rac2030/IoT-conference-badge/images/design-prototype-modular-approach.png

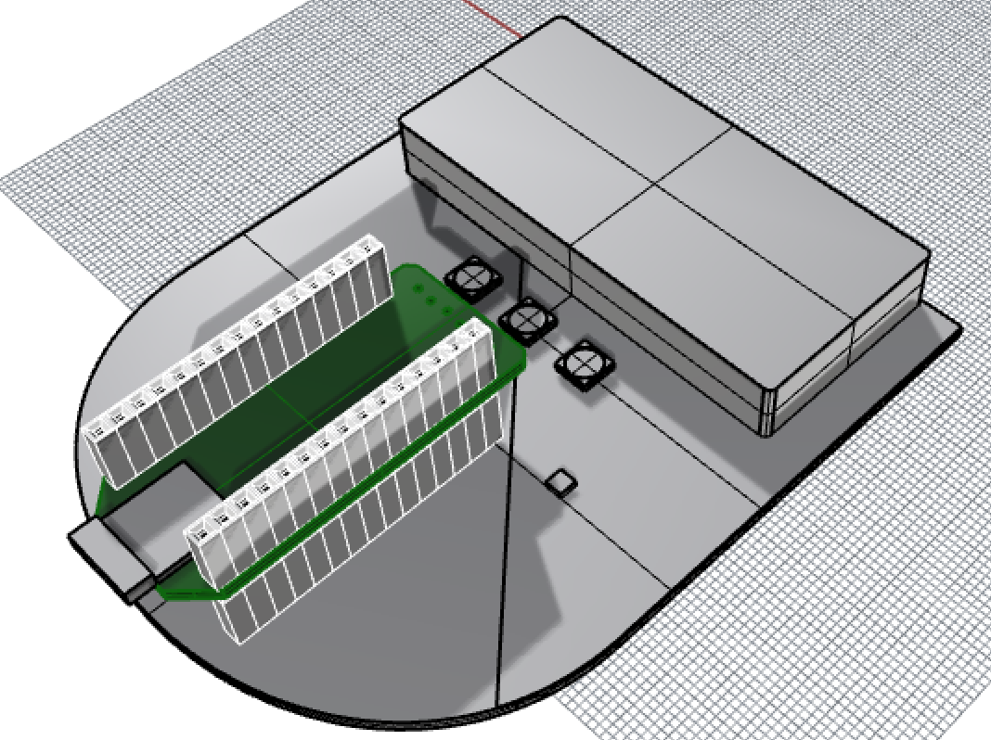
images/design-prototype-modular-approach.png
