rac2030/IoT-conference-badge/README.md

# IoT-conference-badge
Hardware badge to be used in MakeZürich 2018 (https://makezurich.ch) and GDG DevFest Switzerland 2018 (https://devfest.ch)

More info for the uC module used here can be found on http://rac.su/ninab together with the sources (it's on GitHub as well)
