rac2030/IoT-conference-badge/firmware/examples/i2c_scanner/README.md

# i2c scanner

Sample sketch to scan the I2C bus and report found devices. It's the 
same code as seen on the [Arduino Playground](https://playground.arduino.cc/Main/I2cScanner),
with the only difference of adapting the `Serial` speed to the defaults of the NINA module.
