rac2030/IoT-conference-badge/firmware/examples/LED-OFF/README.md

# LED OFF

Turns off both LEDs on the MakeZurich badge 2018 to reset in case a new programm will be flashed that does not set the LED state hence they keep the last state.
