rac2030/IoT-conference-badge/firmware/examples/LED-Siren/README.md

# LED Siren example

Just flashes different patterns that mimik a US police siren with red and blue on the MakeZurich badge 2018
