rac2030/IoT-conference-badge/firmware/examples/sht-autodetect/README.md

# SHT-Autodetect

Very simple sensor test using Sensirion SHT sensors (tested with SHT31) based on the examples of [Sensirion's Arduino SHT lib](https://github.com/Sensirion/arduino-sht).

## Wiring

* `SCL` -> `IO35` (NINA nomenclature)
* `SDA` -> `IO36` (NINA nomenclature)
* `VCC` -> `VCC`
* `GND` -> `GND`

## Libraries

Install the following libraries using Arduino IDE (`Sketch` -> `Include Library` -> `Manage Libraries...`):

* [Sensirion's Arduino SHT](https://github.com/Sensirion/arduino-sht)
