rac2030/IoT-conference-badge/graphics/DuckTapeApproved.bmp

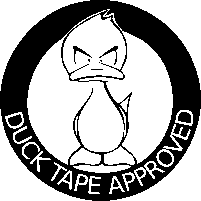
graphics/DuckTapeApproved.bmp
