rac2030/IoT-conference-badge/graphics/qr-racsu-mz18quest.png

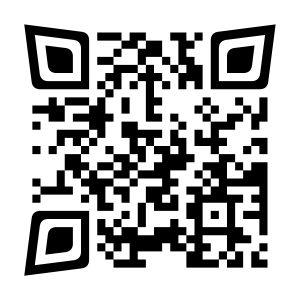
graphics/qr-racsu-mz18quest.png
