rac2030/IoT-conference-badge/3d-models/parts/headers/BG130-05-X-0350-X-X_revE.STEP

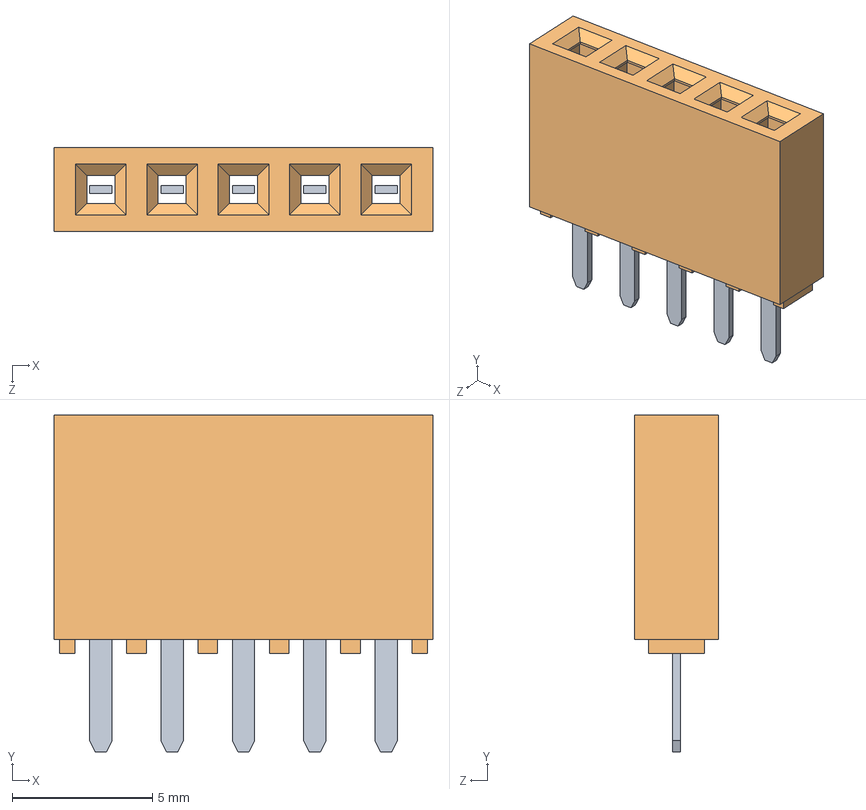
[picture p4: CAD file, 2018-05-28]
3d-models/parts/headers/BG130-05-X-0350-X-X_revE.STEP
13.5 x 12.0 x 3.00 mm
BG130-PIN x 5
BG130-05-INS
