rac2030/IoT-conference-badge/hardware/kicad-libs/SamacSys/LDO/LIB_LTC3101EUF#PBF/LTC3101EUF#PBF/3D/LTC3101EUF#PBF.stp

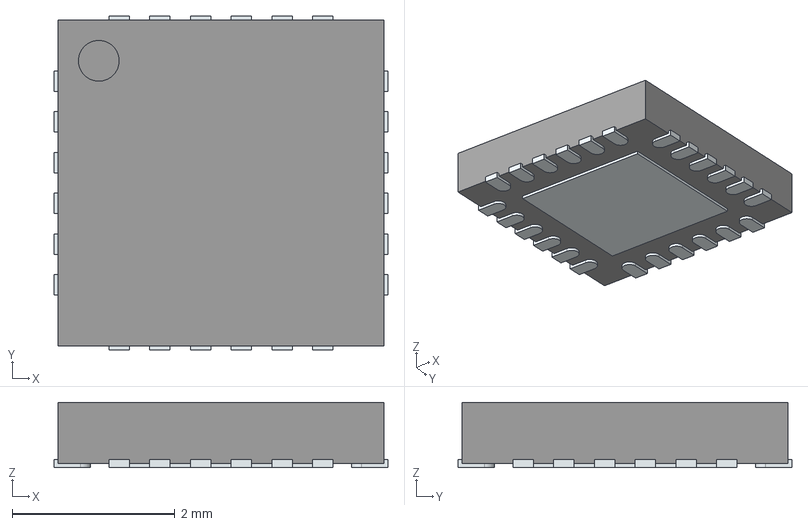
[picture p5: CAD file, 2018-05-28]
hardware/kicad-libs/SamacSys/LDO/LIB_LTC3101EUF#PBF/LTC3101EUF#PBF/3D/LTC3101EUF#PBF.stp
4.10 x 4.10 x 0.8 mm
ThermalPin
PinsArrayLR
PinsArrayTB
