rac2030/IoT-conference-badge/hardware/kicad-libs/SamacSys/LDO/TPS767D318PWP.stp

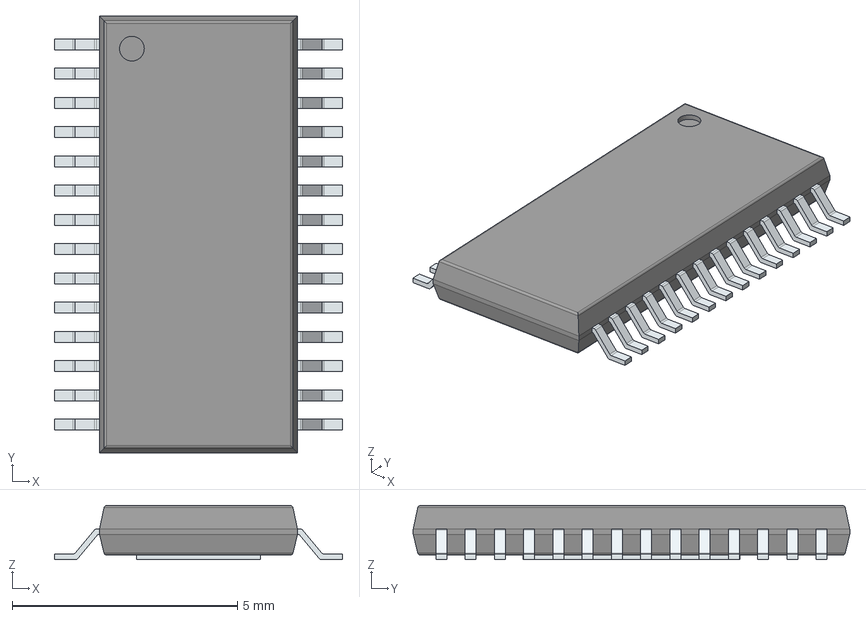
[picture p6: CAD file, 2018-05-28]
hardware/kicad-libs/SamacSys/LDO/TPS767D318PWP.stp
6.40 x 9.70 x 1.20 mm
PinsArrayLR
ThermalPad
