rac2030/IoT-conference-badge/hardware/kicad-libs/SamacSys/LIB_CP2102N-A01-GQFN20/CP2102N-A01-GQFN20/3D/CP2102N-A01-GQFN20.stp

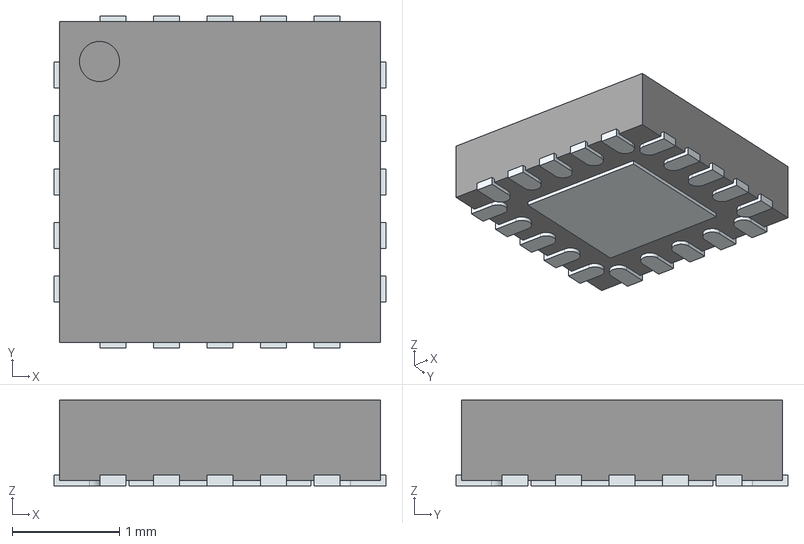
[picture p7: CAD file, 2018-05-28]
hardware/kicad-libs/SamacSys/LIB_CP2102N-A01-GQFN20/CP2102N-A01-GQFN20/3D/CP2102N-A01-GQFN20.stp
3.10 x 3.10 x 0.8 mm
ThermalPin
PinsArrayLR
PinsArrayTB
