rac2030/IoT-conference-badge/hardware/kicad-libs/SamacSys/PCA9306/PCA9306TDCURQ1.stp

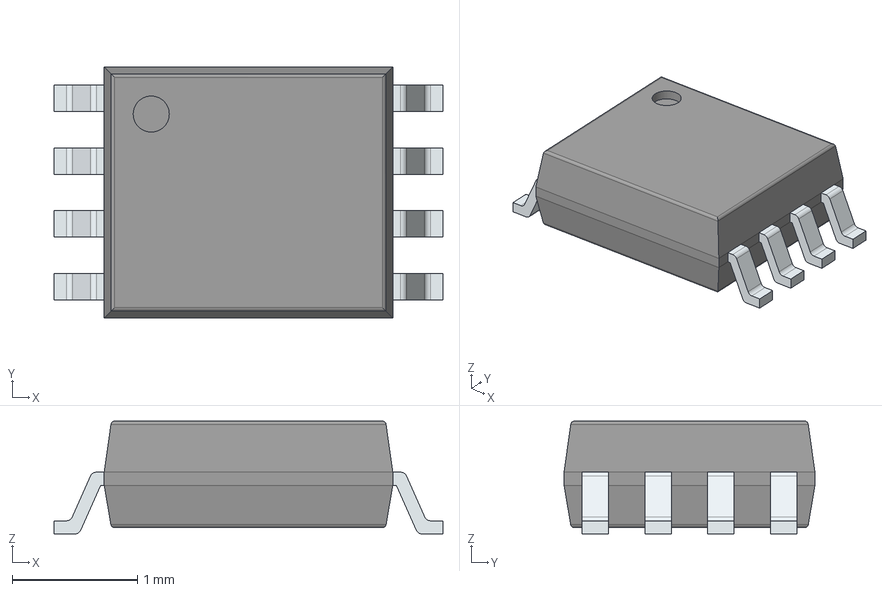
[picture p8: CAD file, 2018-05-28]
hardware/kicad-libs/SamacSys/PCA9306/PCA9306TDCURQ1.stp
3.10 x 2.00 x 0.9 mm
PinsArrayLR
