rac2030/IoT-conference-badge/hardware/kicad-libs/SamacSys/Sensirion/SGPC3-2.5k.stp

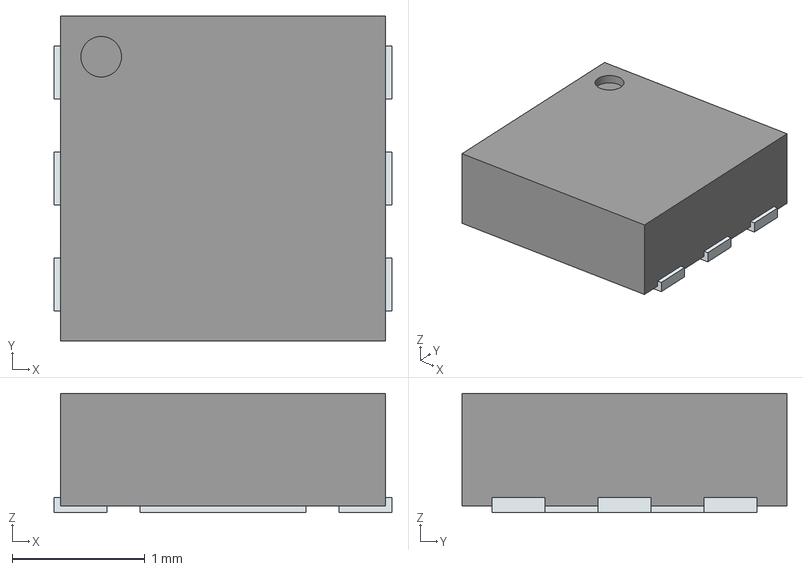
[picture p9: CAD file, 2018-05-28]
hardware/kicad-libs/SamacSys/Sensirion/SGPC3-2.5k.stp
2.55 x 2.45 x 0.9 mm
ThermalPin
PinsArrayLR
