rac2030/IoT-conference-badge/3d-models/parts/headers/BG045-10-X-0600-0300-X-X_revD.STEP

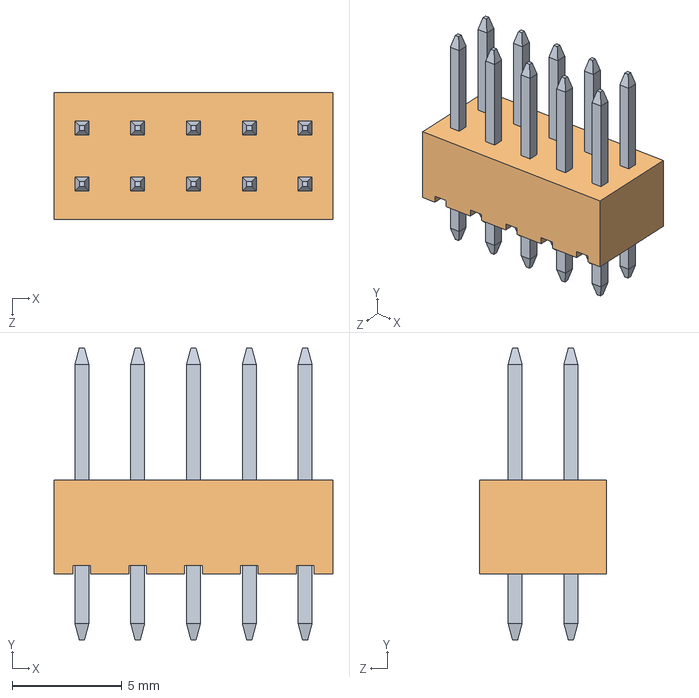
[picture p10: CAD file, 2018-05-28]
3d-models/parts/headers/BG045-10-X-0600-0300-X-X_revD.STEP
12.7 x 13.3 x 5.80 mm
BG045-Contact-0600-0300 x 10
BG045-10con-Insulator
