rac2030/IoT-conference-badge/hardware/kicad-libs/SamacSys/Sensirion/SHTC1.stp

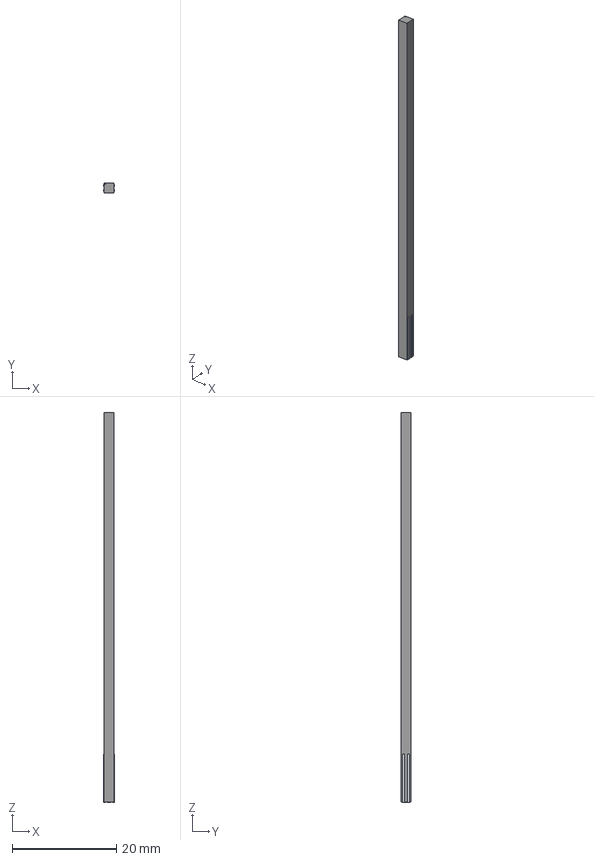
[picture p11: CAD file, 2018-05-28]
hardware/kicad-libs/SamacSys/Sensirion/SHTC1.stp
2.10 x 2.00 x 75.0 mm
ThermalPin
PinsArrayLR
