rac2030/IoT-conference-badge/3d-models/parts/headers/BG180-10-X-0-X-X_revE.STEP

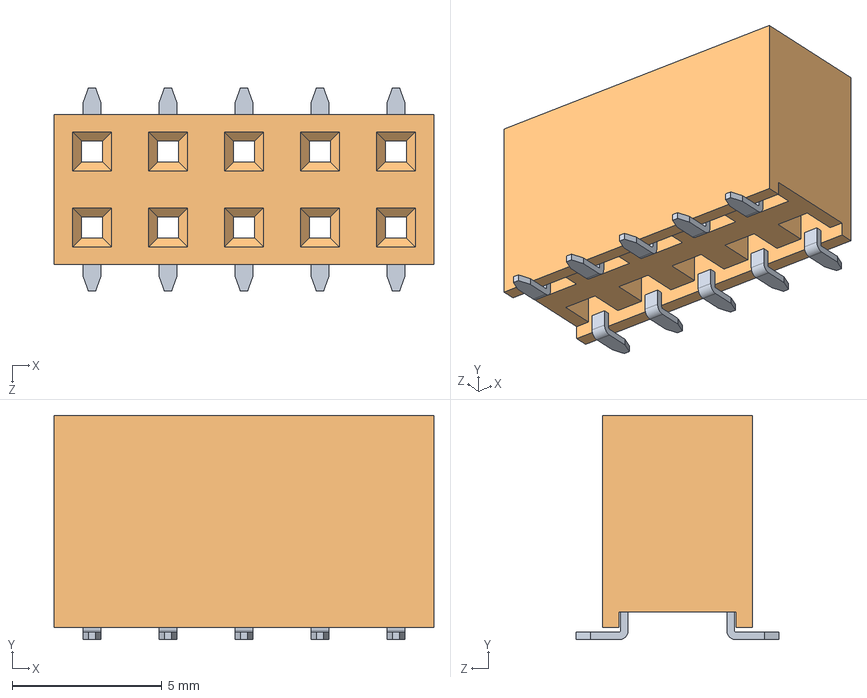
[picture p12: CAD file, 2018-05-28]
3d-models/parts/headers/BG180-10-X-0-X-X_revE.STEP
12.7 x 7.50 x 6.80 mm
BG180-Contact x 10
BG180-5way_insulator
