rac2030/IoT-conference-badge/3d-models/parts/headers/BG120-40-X-1-X-X_revD.STEP

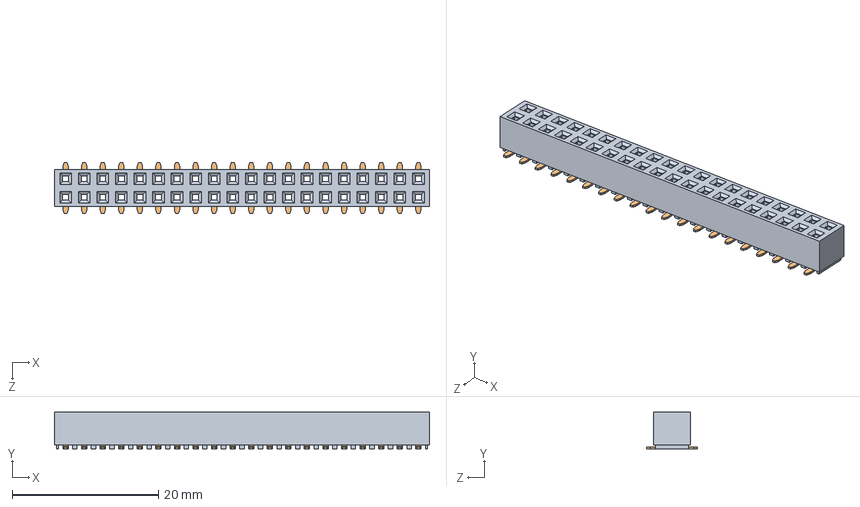
[picture p13: CAD file, 2018-05-28]
3d-models/parts/headers/BG120-40-X-1-X-X_revD.STEP
51.3 x 5.00 x 7.00 mm
BG120-20way-Ins-w-post
BG120-Contact x 40
