rac2030/IoT-conference-badge/hardware/kicad-libs/SamacSys/TPS78918DBVT/3D/TPS78918DBVT.stp

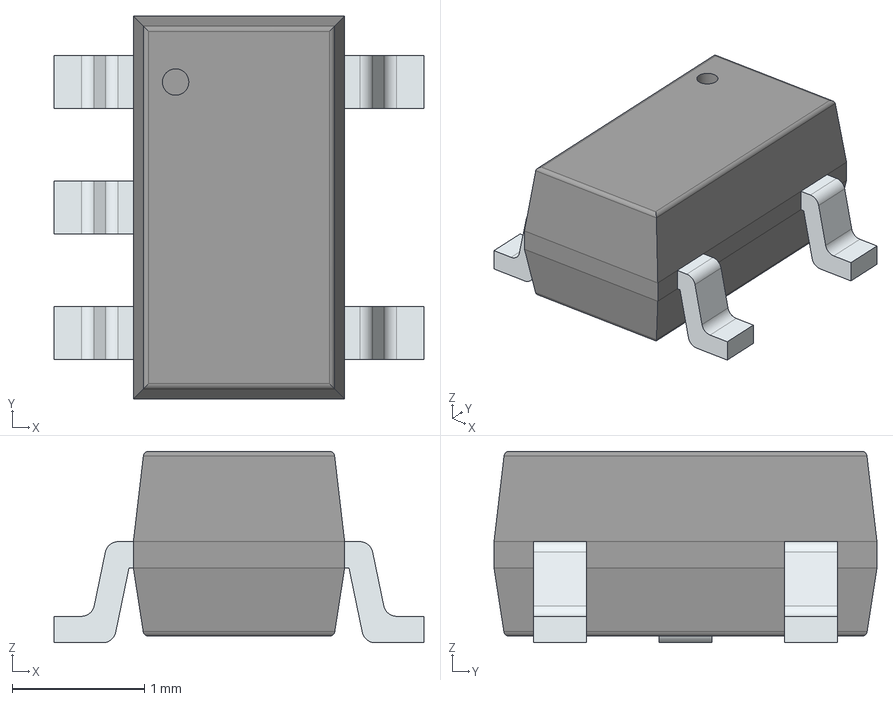
[picture p14: CAD file, 2018-05-28]
hardware/kicad-libs/SamacSys/TPS78918DBVT/3D/TPS78918DBVT.stp
2.80 x 2.90 x 1.45 mm
PinsArrayL
PinsArrayR
