rac2030/IoT-conference-badge/(list of files, cad)

Other CAD files:
hardware/kicad-libs/SamacSys/LDO/LIB_LTC3101EUF#PBF/LTC3101EUF#PBF/3D/LTC3101EUF#PBF.stl
hardware/kicad-libs/SamacSys/LDO/TPS767D318PWP.stl
hardware/kicad-libs/SamacSys/LIB_CP2102N-A01-GQFN20/CP2102N-A01-GQFN20/3D/CP2102N-A01-GQFN20.stl
hardware/kicad-libs/SamacSys/PCA9306/PCA9306TDCURQ1.stl
hardware/kicad-libs/SamacSys/Sensirion/SGPC3-2.5k.stl
hardware/kicad-libs/SamacSys/Sensirion/SHTC1.stl
hardware/kicad-libs/SamacSys/TPS78918DBVT/3D/TPS78918DBVT.stl
