rac2030/IoT-conference-badge/hardware/kicad-libs/SamacSys/TPS78918DBVT/How_To_Use_Models.pdf

ECAD PART WIZARD.

Supports:

Offers engineers full control of the symbol fracturing and symbol pin positions (left, right, top, bottom). ECAD Symbols & footprints can be downloaded directly from within the EPW application or from manufacturer and RS Component website.

DOWNLOAD: http://componentsearchengine.com/EPW.html

LIBRARY LOADER.
Allows Engineers to click our icon from any webpage and it injects the symbols and footprint directly into your chosen library and attached them to your cursor ready for placement.

DOWNLOAD: http://componentsearchengine.com/LibraryLoader.php

SamacSys is a leading developer of software tools for creating and managing electronic component ECAD data.

## 3 ways to use our ECAD Schematic Symbols & PCB footprints

Supports:

DIRECT MODEL DOWNLOAD FOR MANUAL USE.
Our Schematic Symbols and PCB Footprint can be downloaded in a zip file for the user to manually load into their existing ECAD Library.

DOWNLOAD: http://componentsearchengine.com

Automatically load
models into your
library and attach
them to your cursor
by clicking our icon
on any website.

WATCH VIDEO (https://componentsearchengine.com/pcb-libraries.php)

Excel plug in. Search
for parts from within
Excel, customise the
fracturing and export
to your chosen ECAD
Tool.

WATCH VIDEO (http://www.samacsys.com/epw/)

You may download our
symbols & footprints in
the format of your
ECAD system for
manually loading into
your library.

MORE INFO (http://www.samacsys.com/pcb-part-libraries/)

Supports:
