rac2030/IoT-conference-badge/(threads)

Thread 10 (2018-06-05):

Monitor buttons and trigger action accordingly

rac2030, 2018-06-05:
Ideally using interrupts to wake up from sleep and then evaluate and take appropriate action

rac2030, 2018-06-27:
Has been implemented in taskButtons

Closed 2018-06-27.

Thread 22 (2018-06-05):

Voting application

rac2030, 2018-06-05:
Small application that lets admins issue a vote that gets displayed on each badge and participants can use the 4 buttons to select an option.
This needs a frontend as well as some firmware code to handle that interaction.

Thread 3 (2018-06-05):

Display chip serial as QR code on display

rac2030, 2018-06-05:
If no display name set yet, show QR code or barcode with serial number for scanning

rac2030, 2018-06-07:
Sample code:
chipid=ESP.getEfuseMac();//The chip ID is essentially its MAC address(length: 6 bytes).
	Serial.printf("ESP32 Chip ID = %04X",(uint16_t)(chipid>>32));//print High 2 bytes
	Serial.printf("%08X\n",(uint32_t)chipid);//print Low 4bytes.

rac2030, 2018-06-07:
Some QR code libraries:

- https://github.com/budnail/QR_Code_Gen3
- https://github.com/ricmoo/QRCode
- https://github.com/davidhend/QR-Code-Generator

rac2030, 2018-06-25:
The taskScheduler example shows a demo integration together with tasks and signals splitting generation and displaying

rac2030, 2018-06-26:
Has been implemented in taskQRInit.cpp that gets triggered from taskinit.cpp when the badge powers up and has no name saved in NVM

Closed 2018-06-26.
