rac2030/IoT-conference-badge/hardware/badge-mainboard-rev.0.3.7.pdf

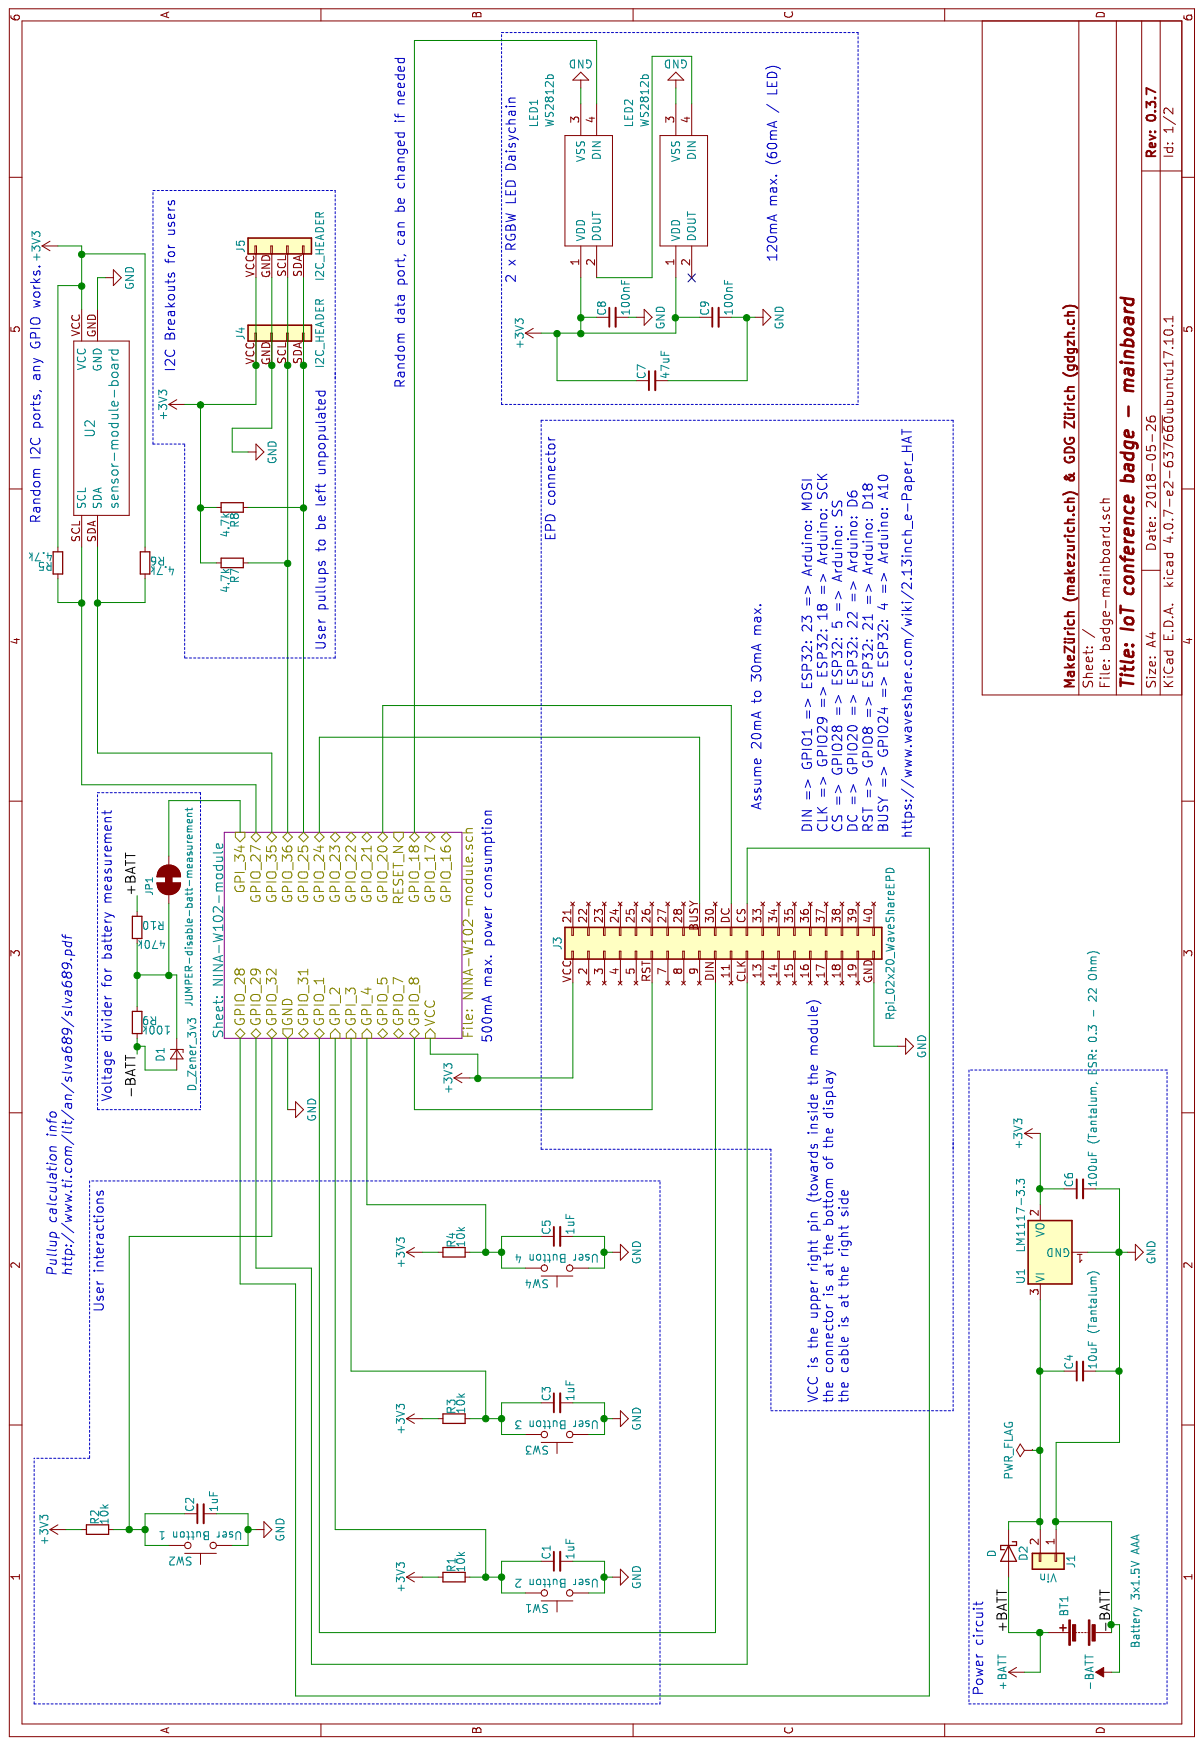
[picture p18: page 1]

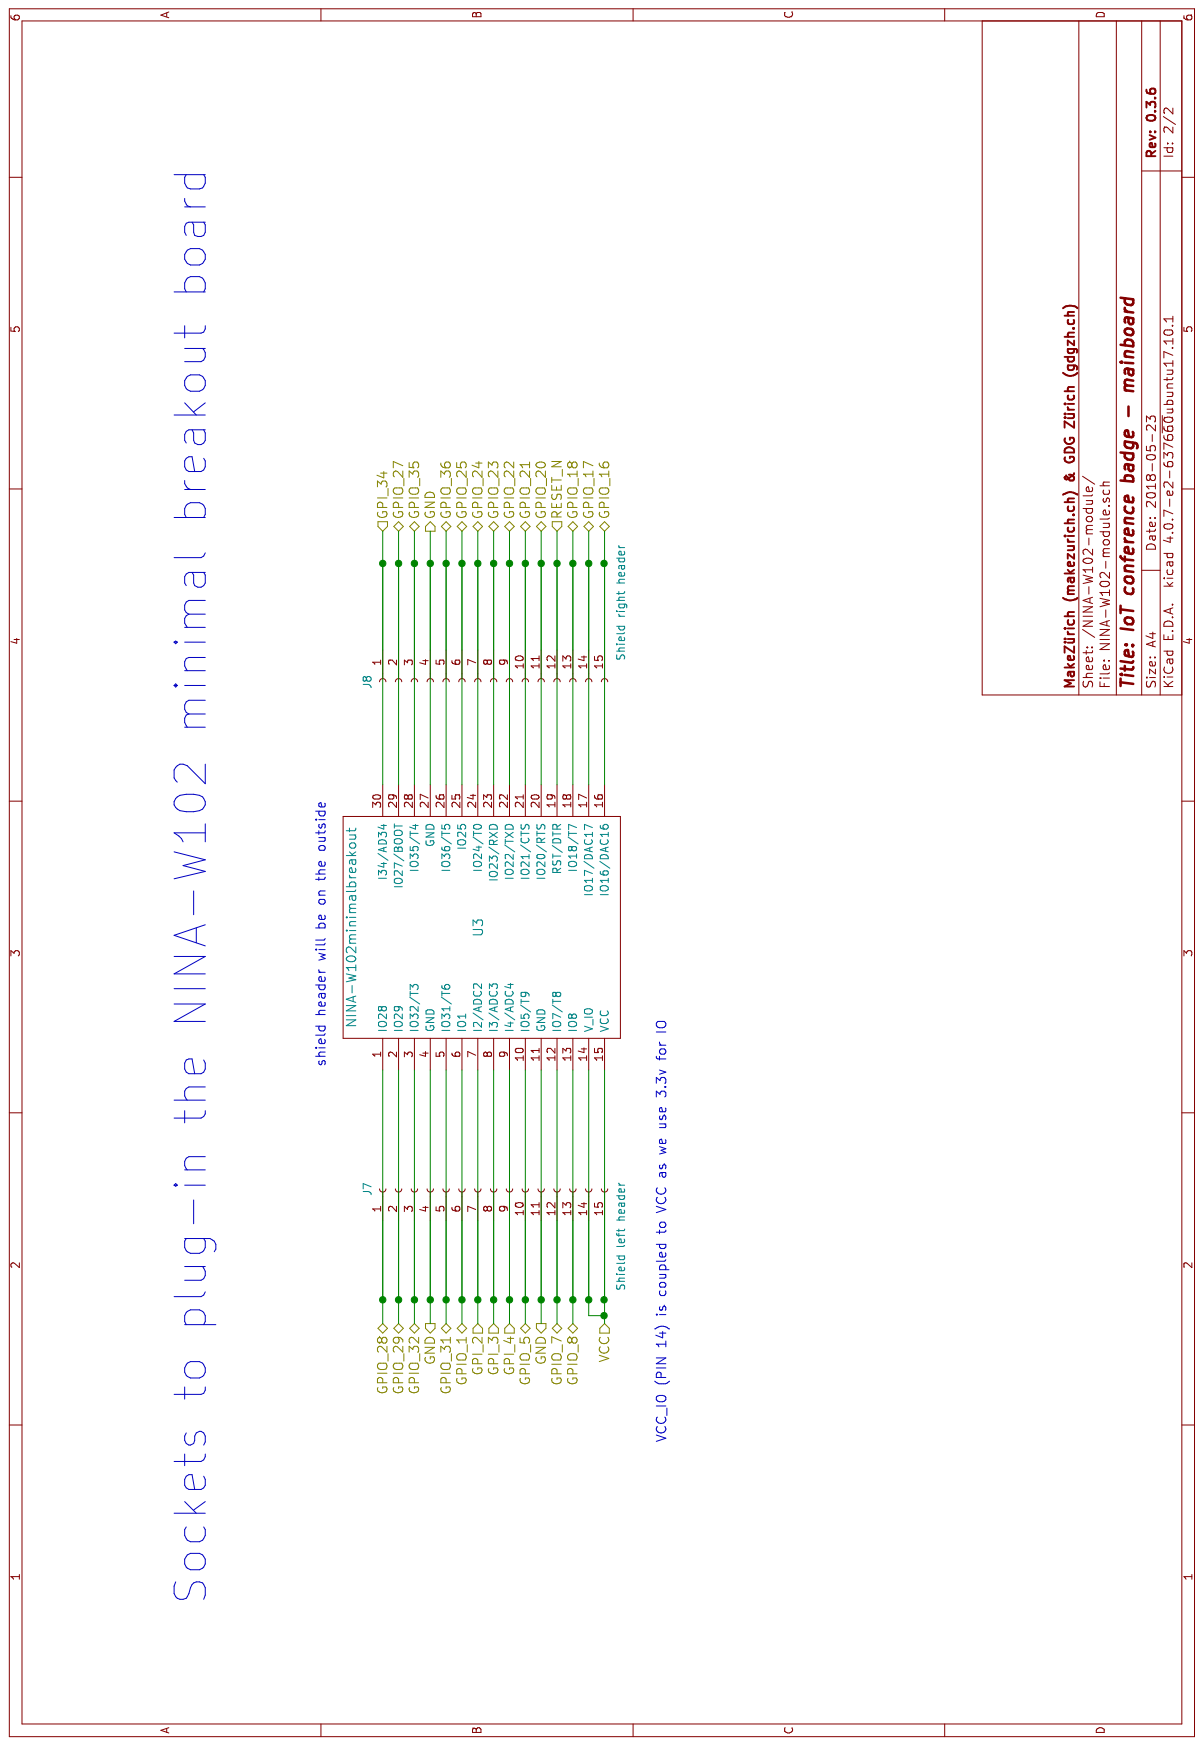
[picture p19: page 2]
