rac2030/IoT-conference-badge/hardware/sensors-module-board-rev.0.1.0.pdf

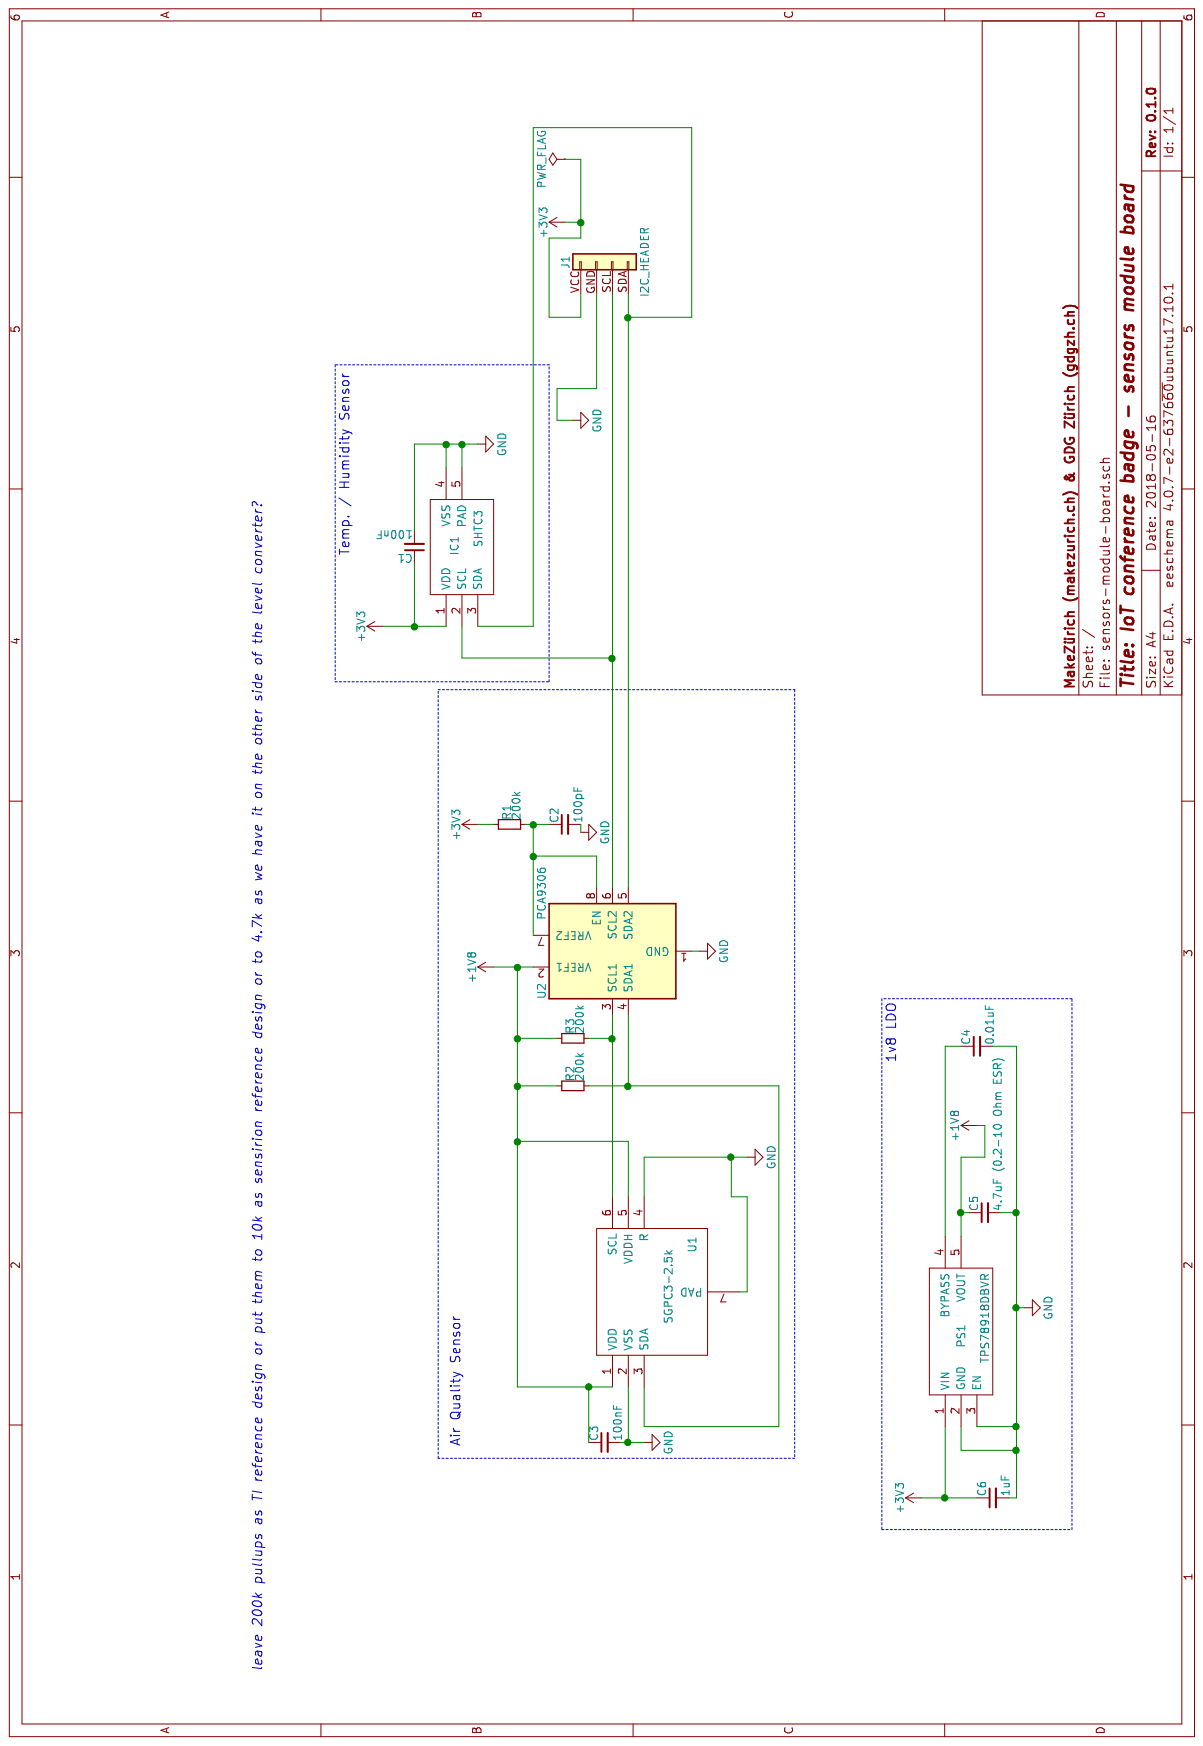
[picture p20: page 1]
