rac2030/IoT-conference-badge/hardware/badge-mainboard-rev.0.1.0.pdf

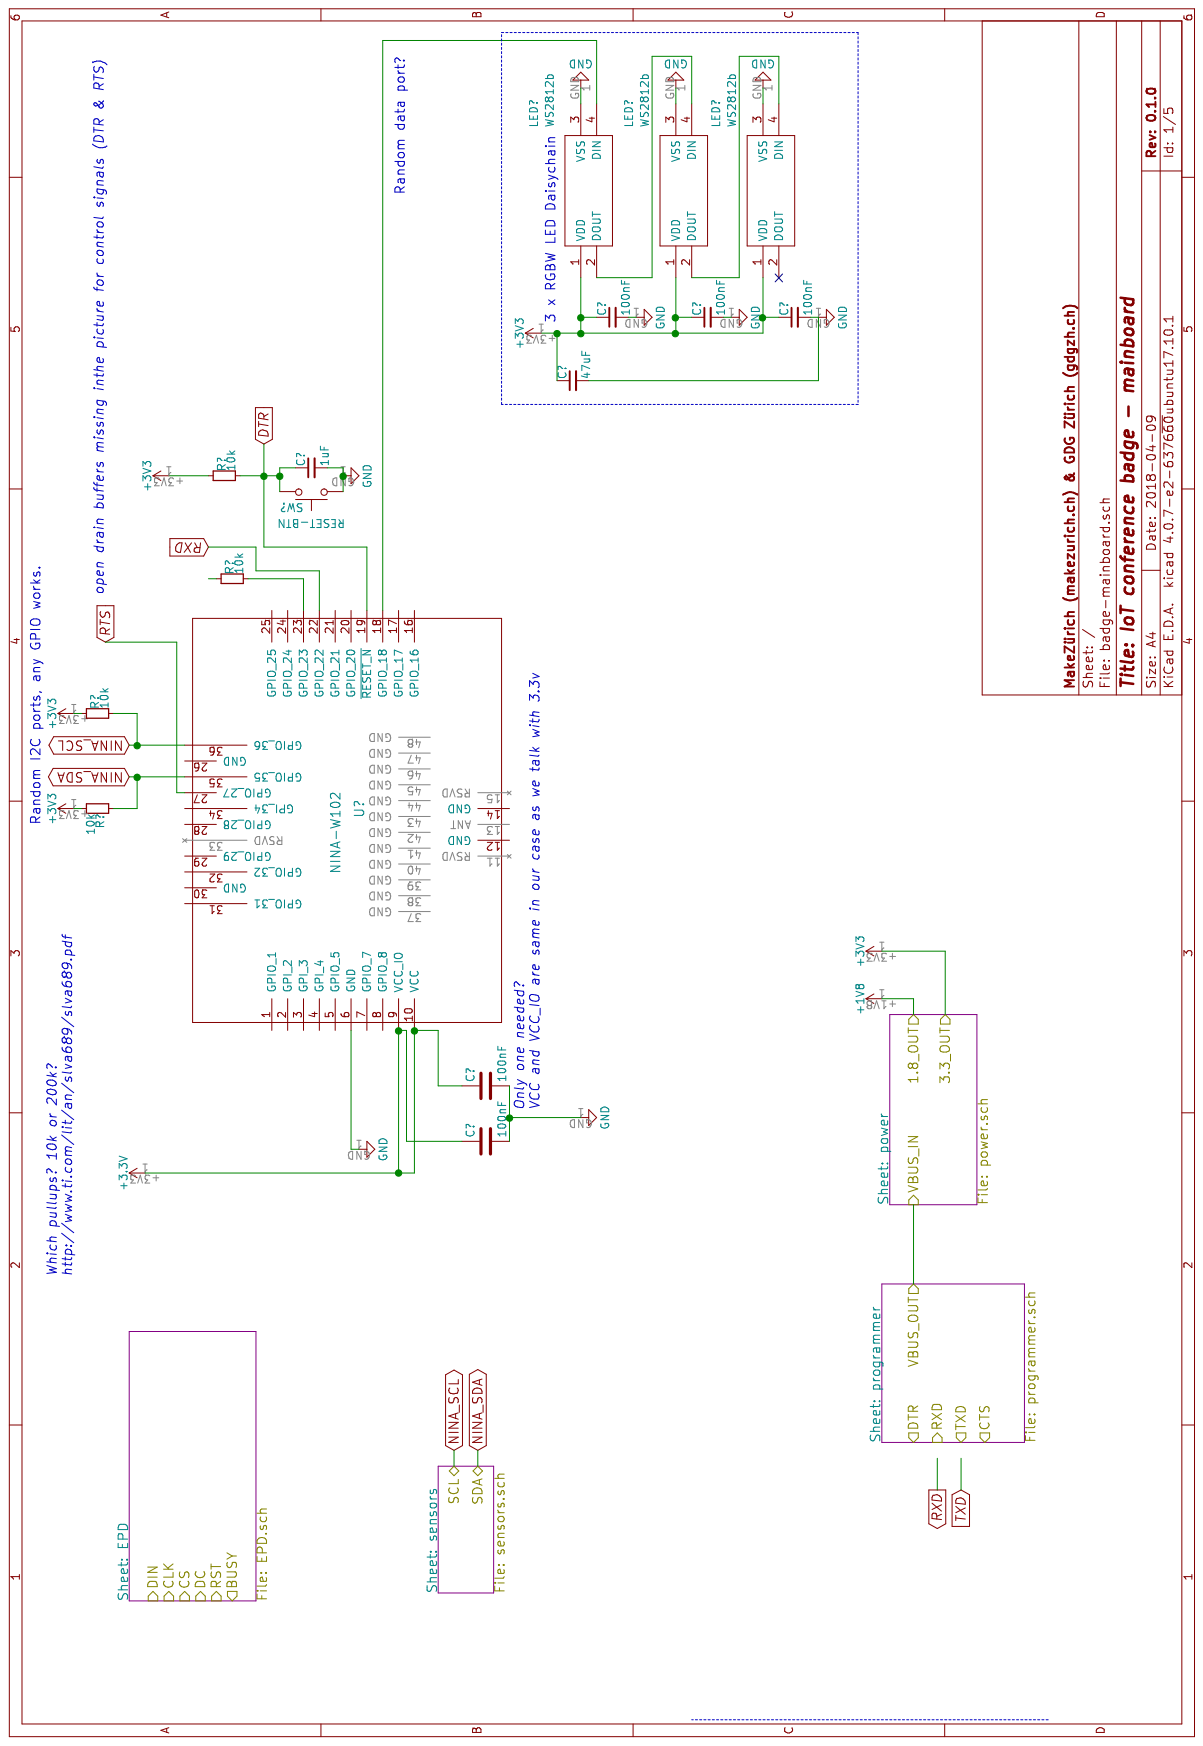
[picture p21: page 1]

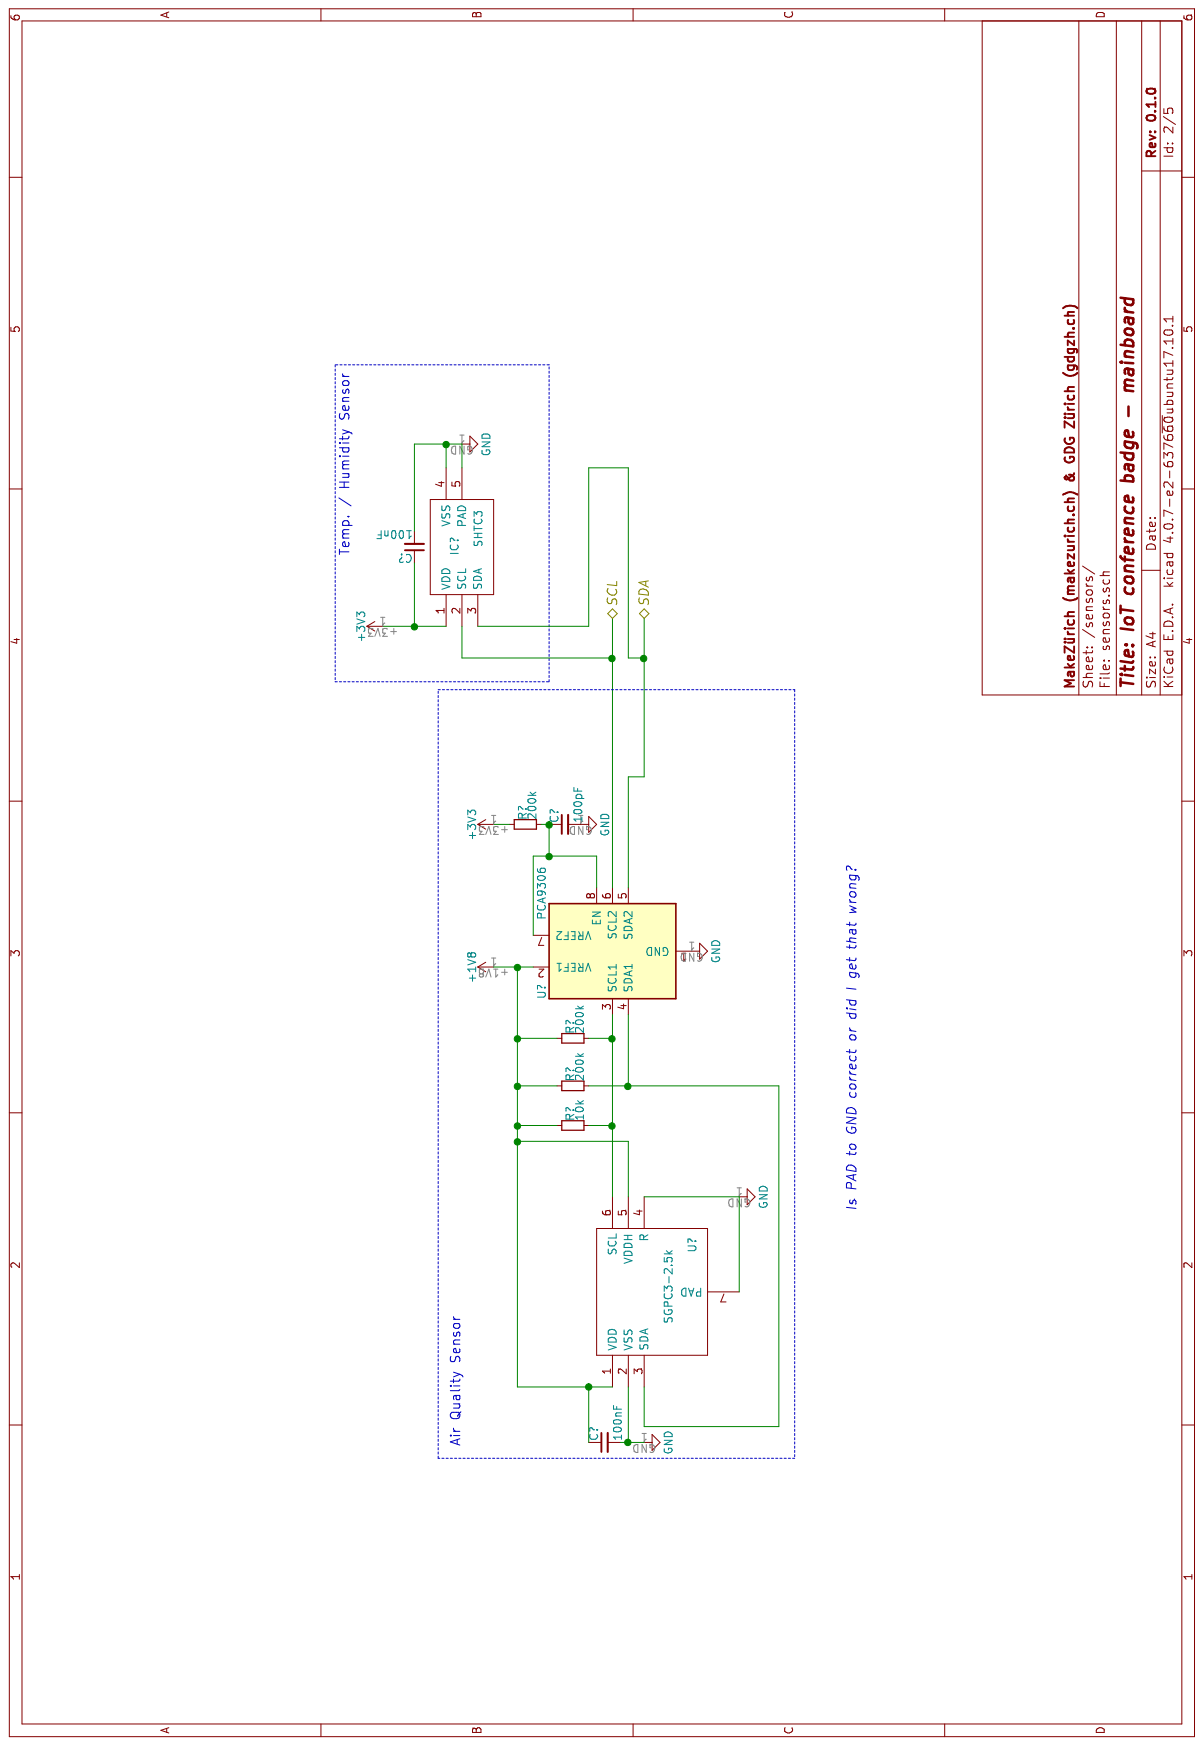
[picture p22: page 2]

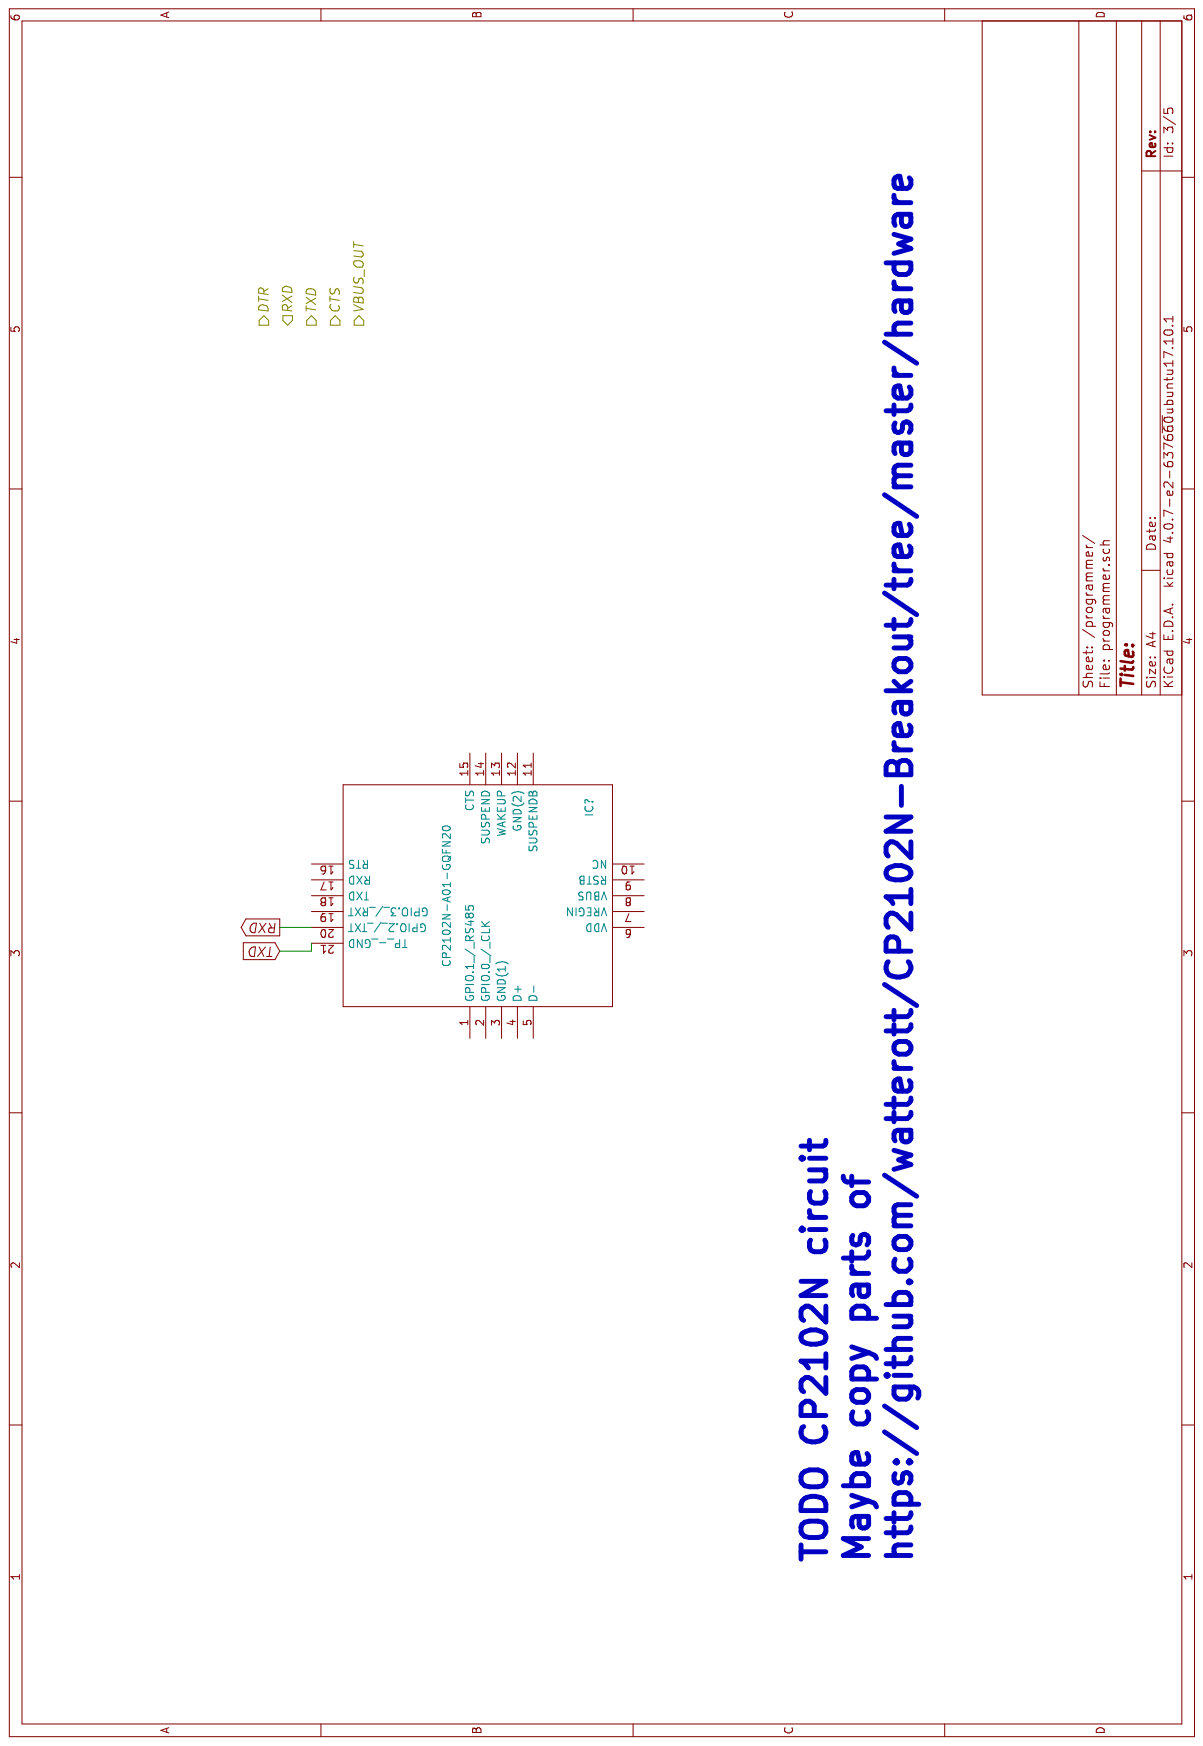
[picture p23: page 3]

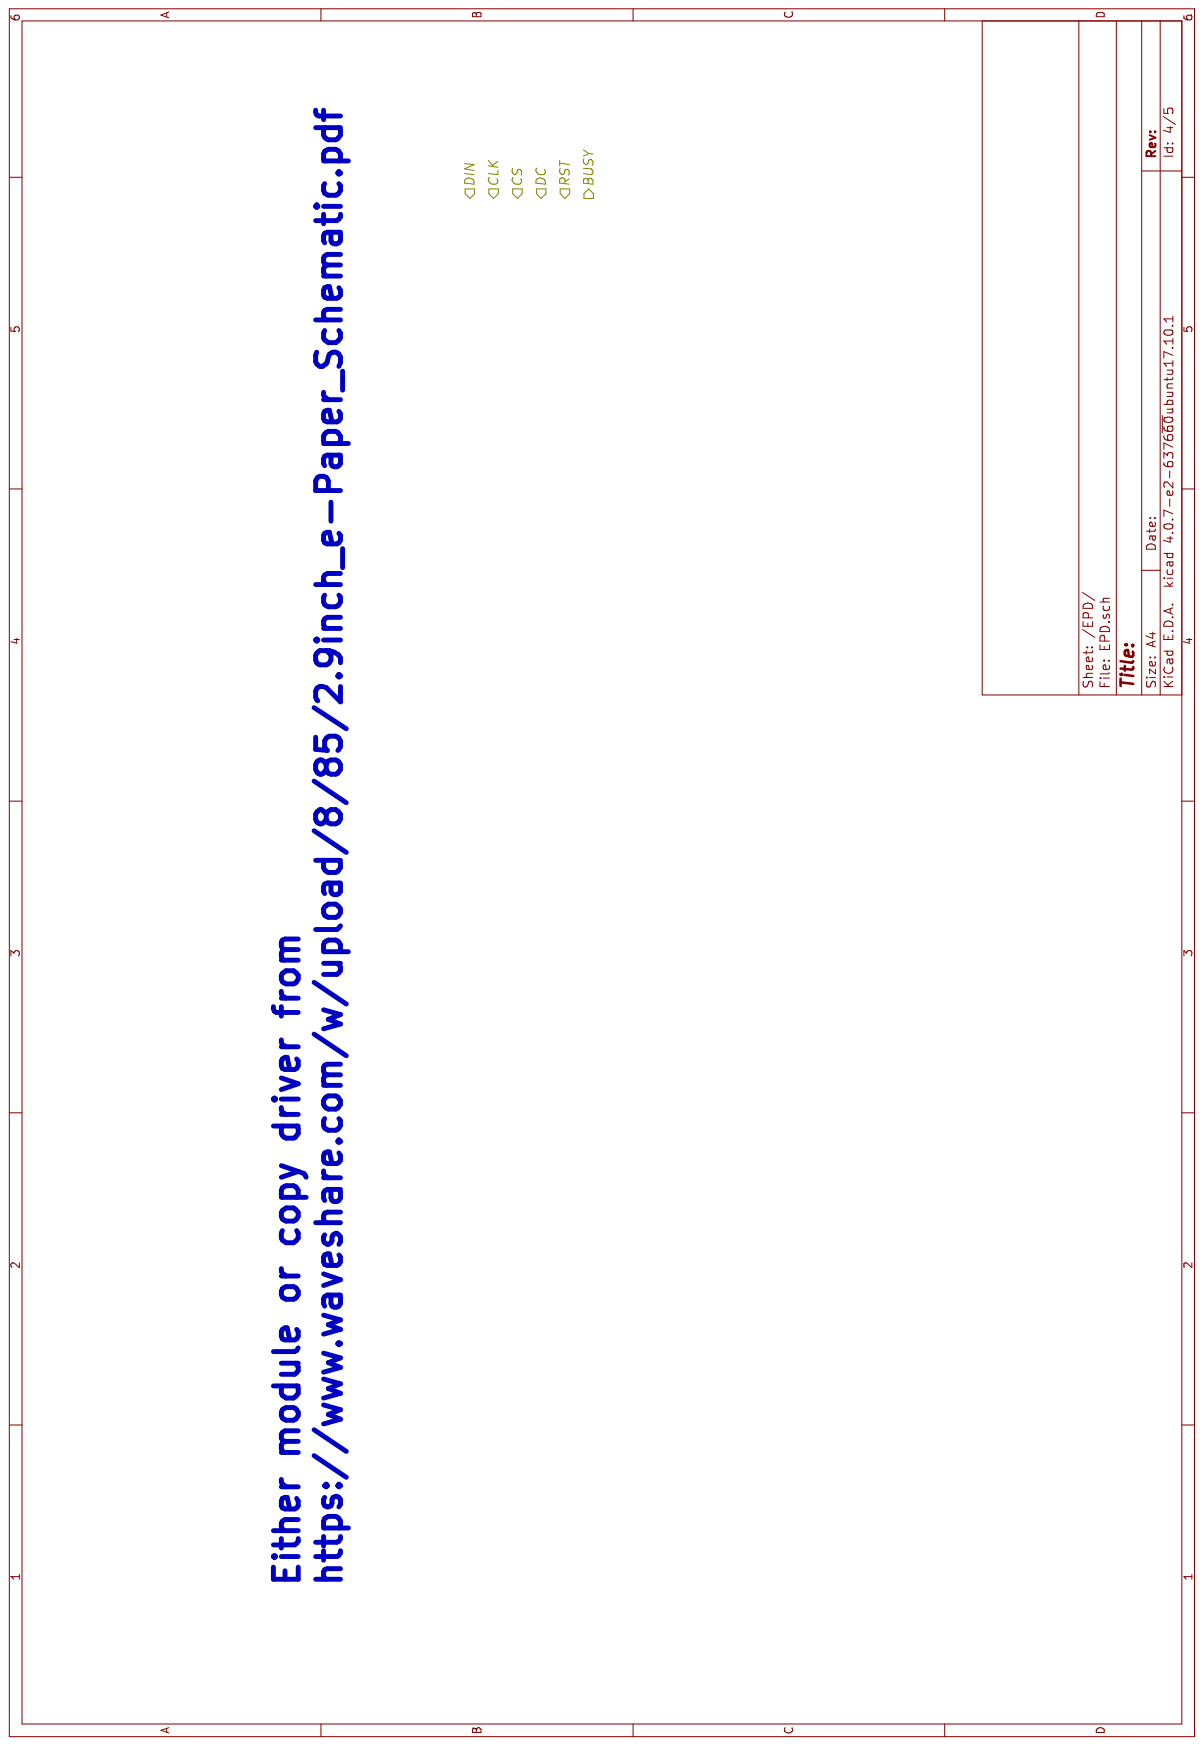
[picture p24: page 4]

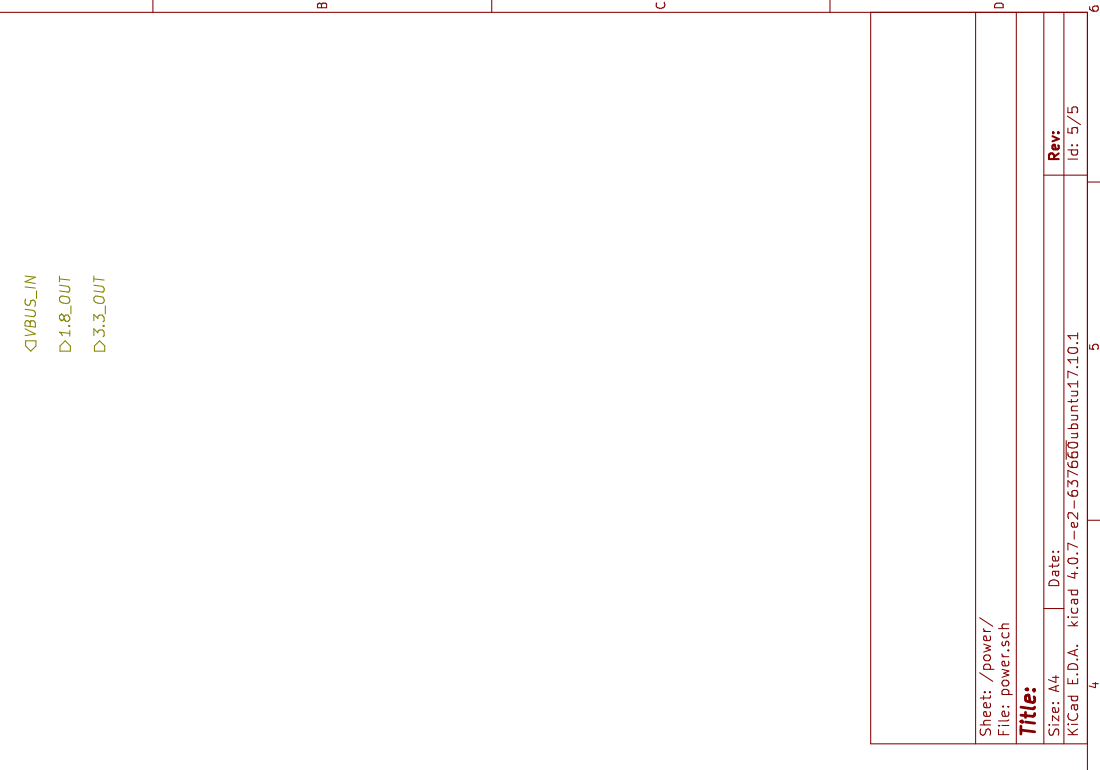
[picture p25: page 5]
