rac2030/IoT-conference-badge/hardware/badge-mainboard-rev.0.3.2.pdf

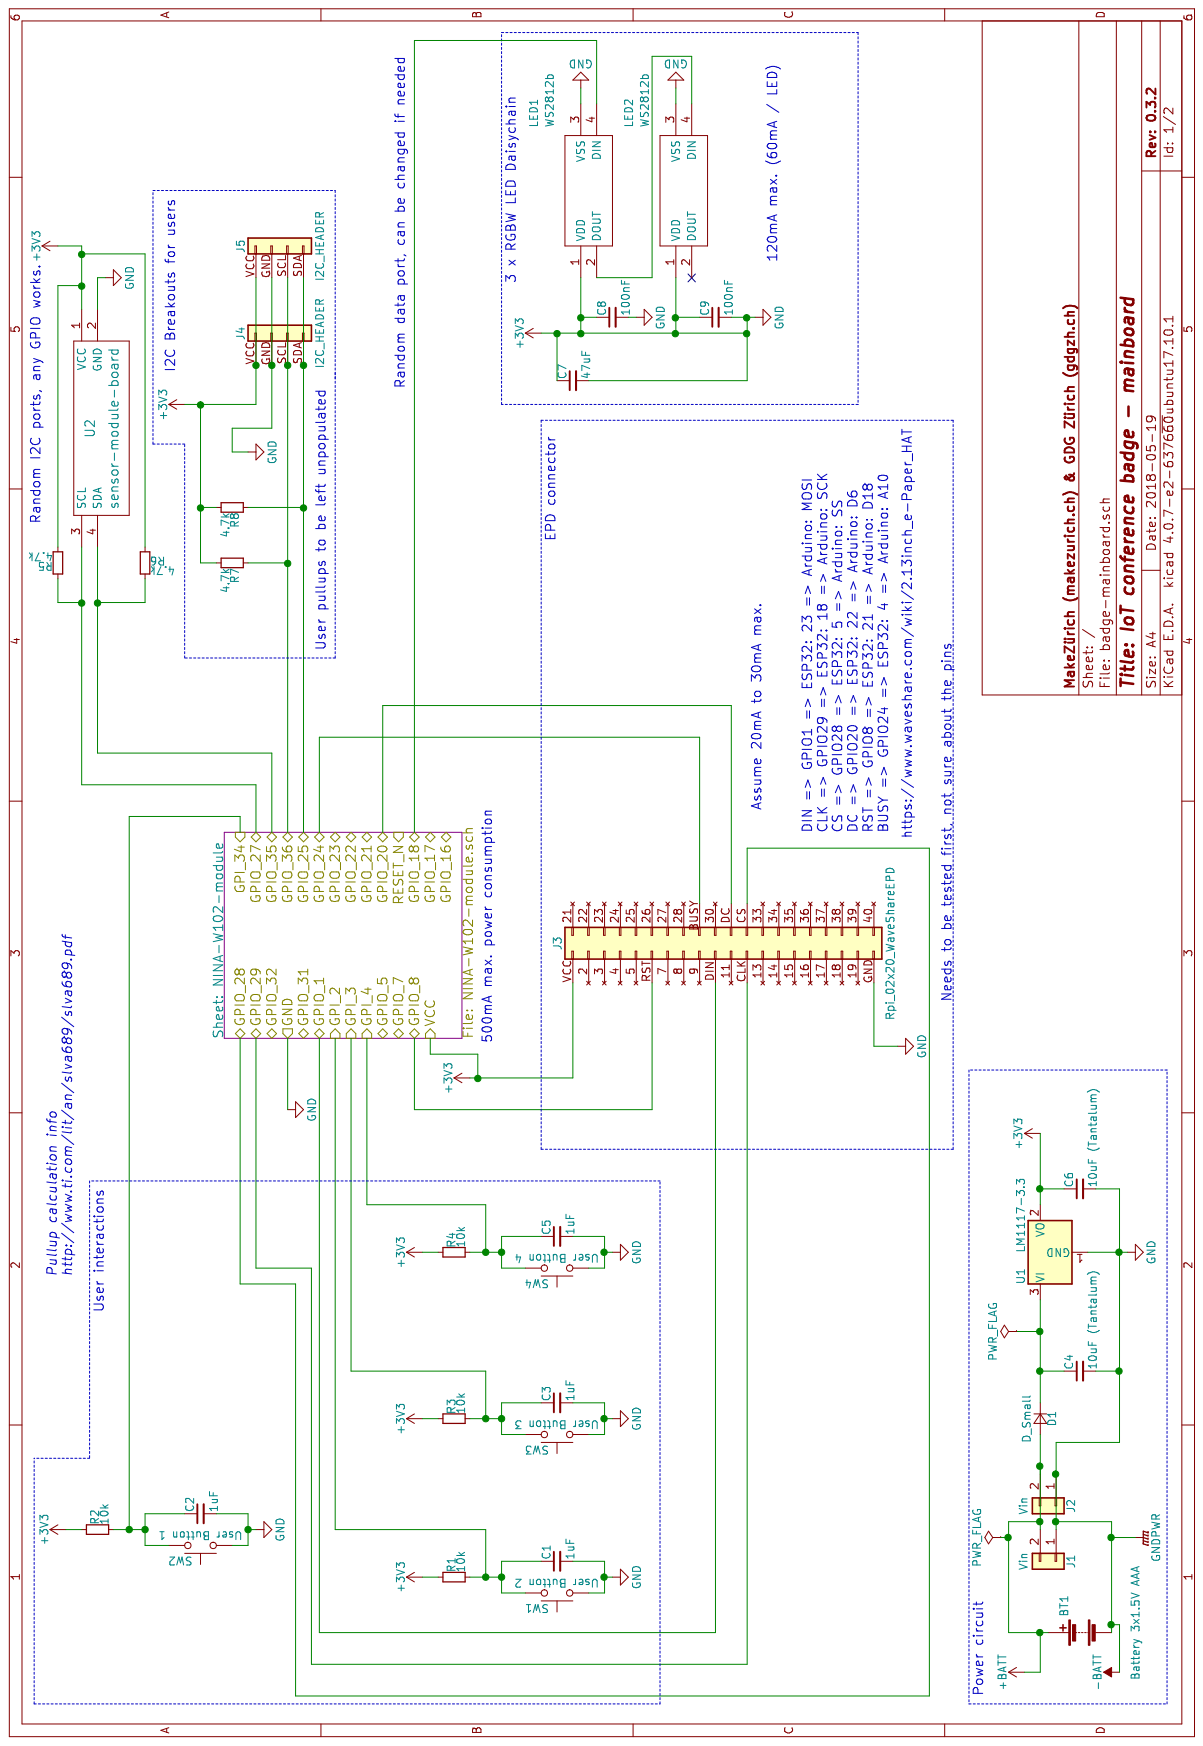
[picture p33: page 1]

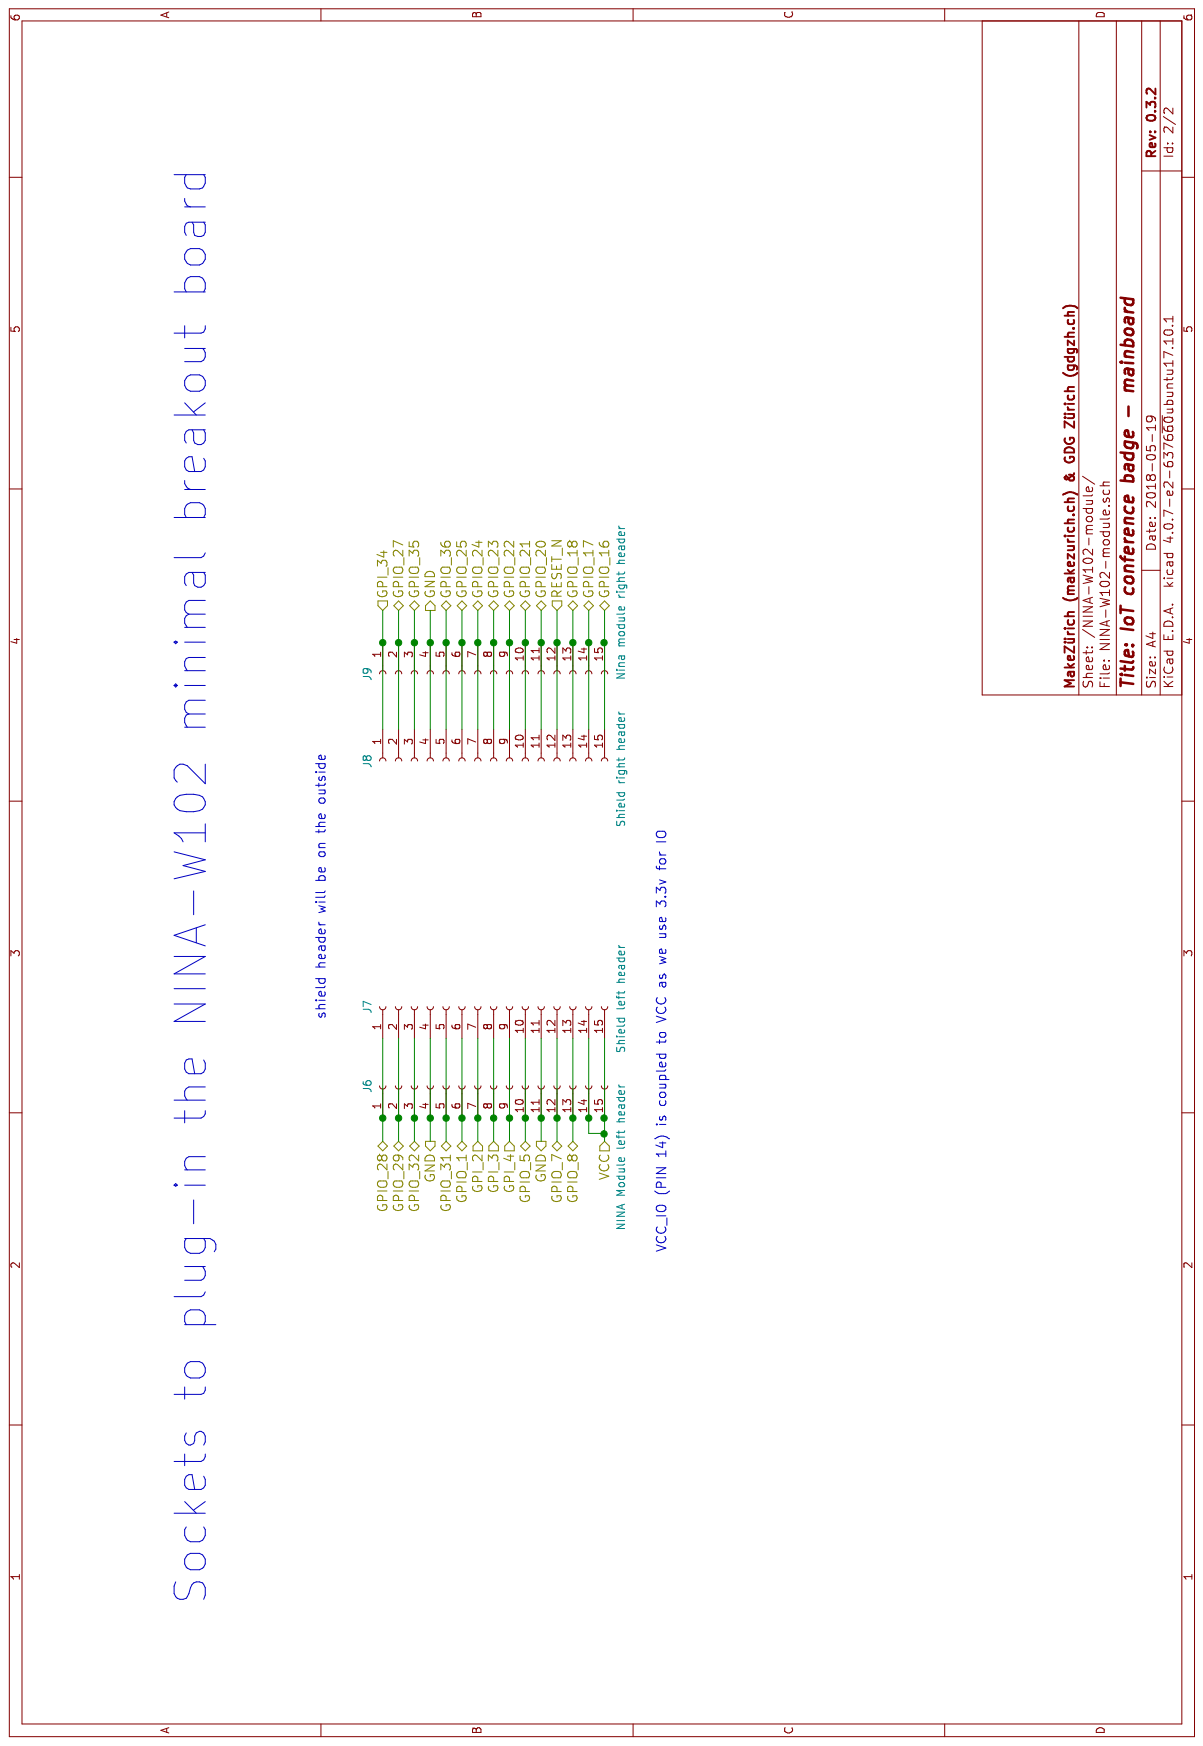
[picture p34: page 2]
