rac2030/IoT-conference-badge/hardware/badge-mainboard-rev.0.3.4.pdf

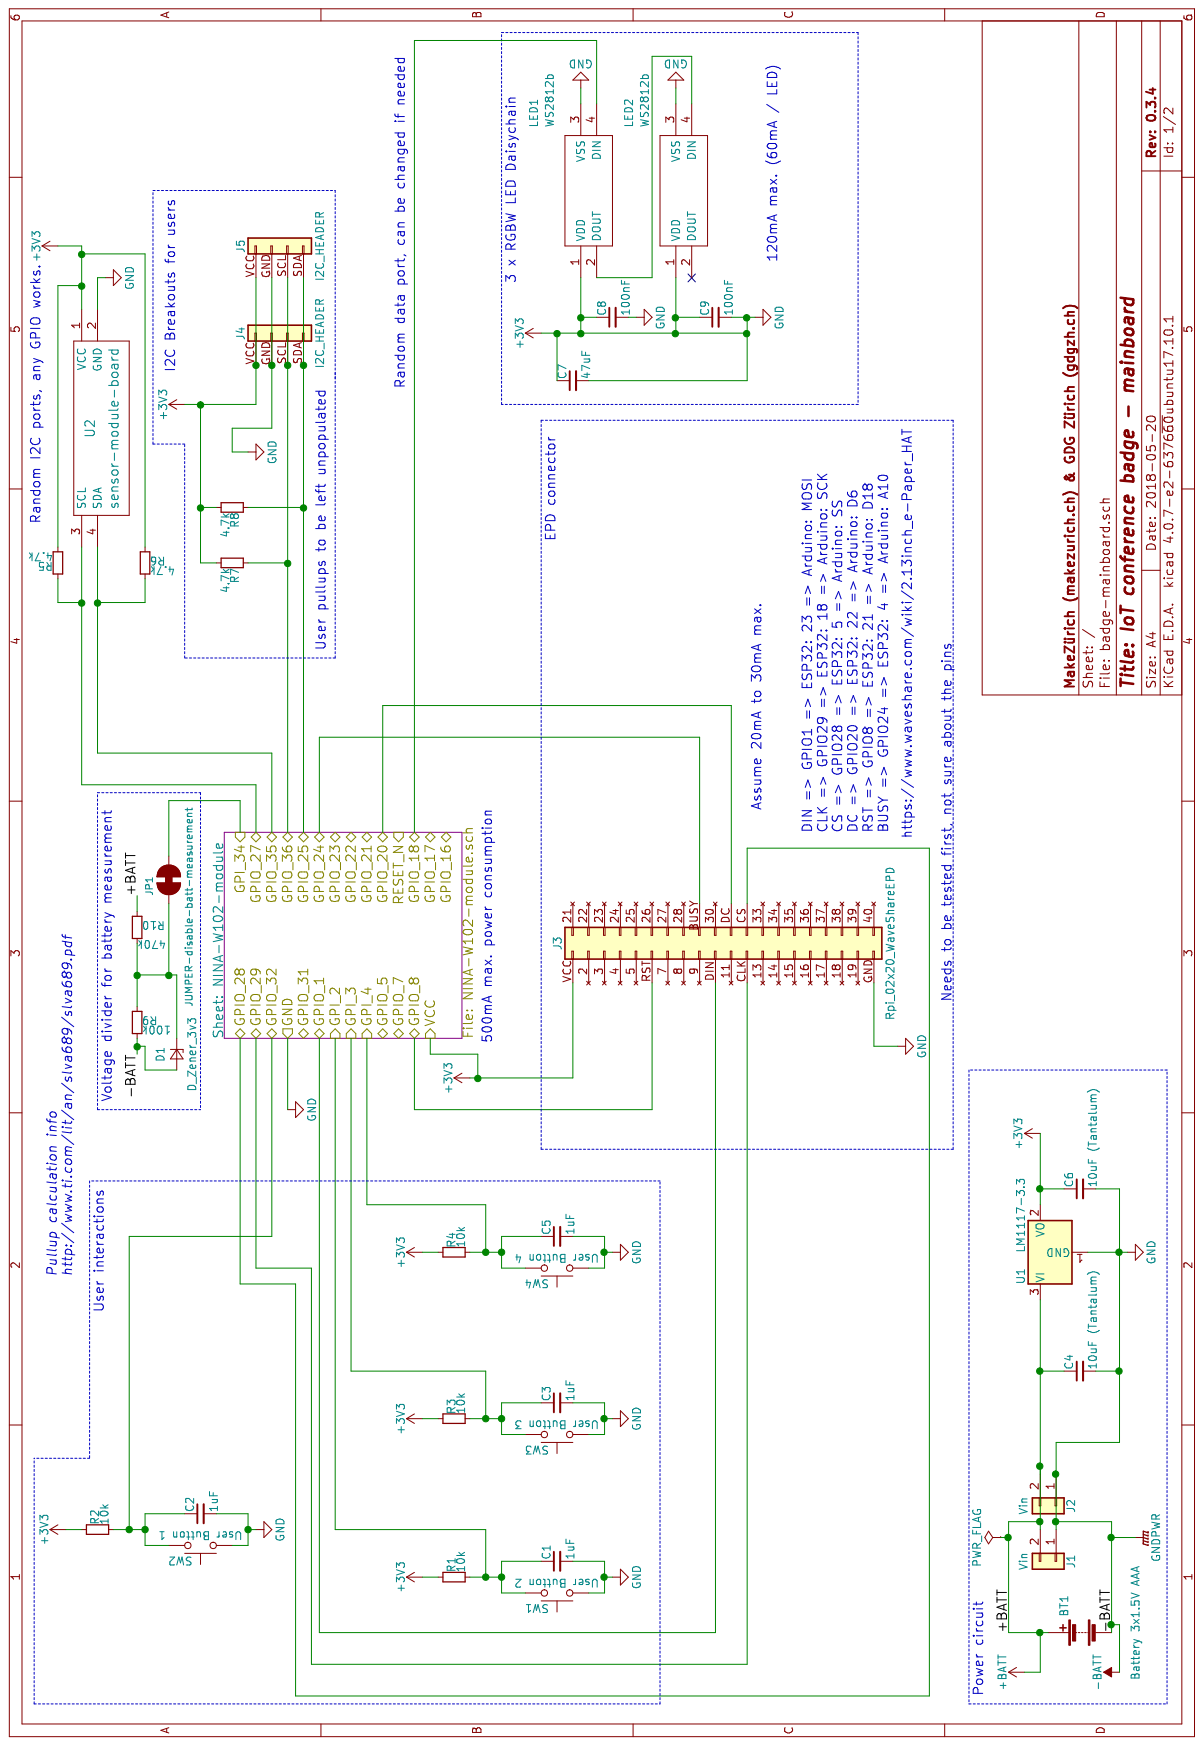
[picture p35: page 1]

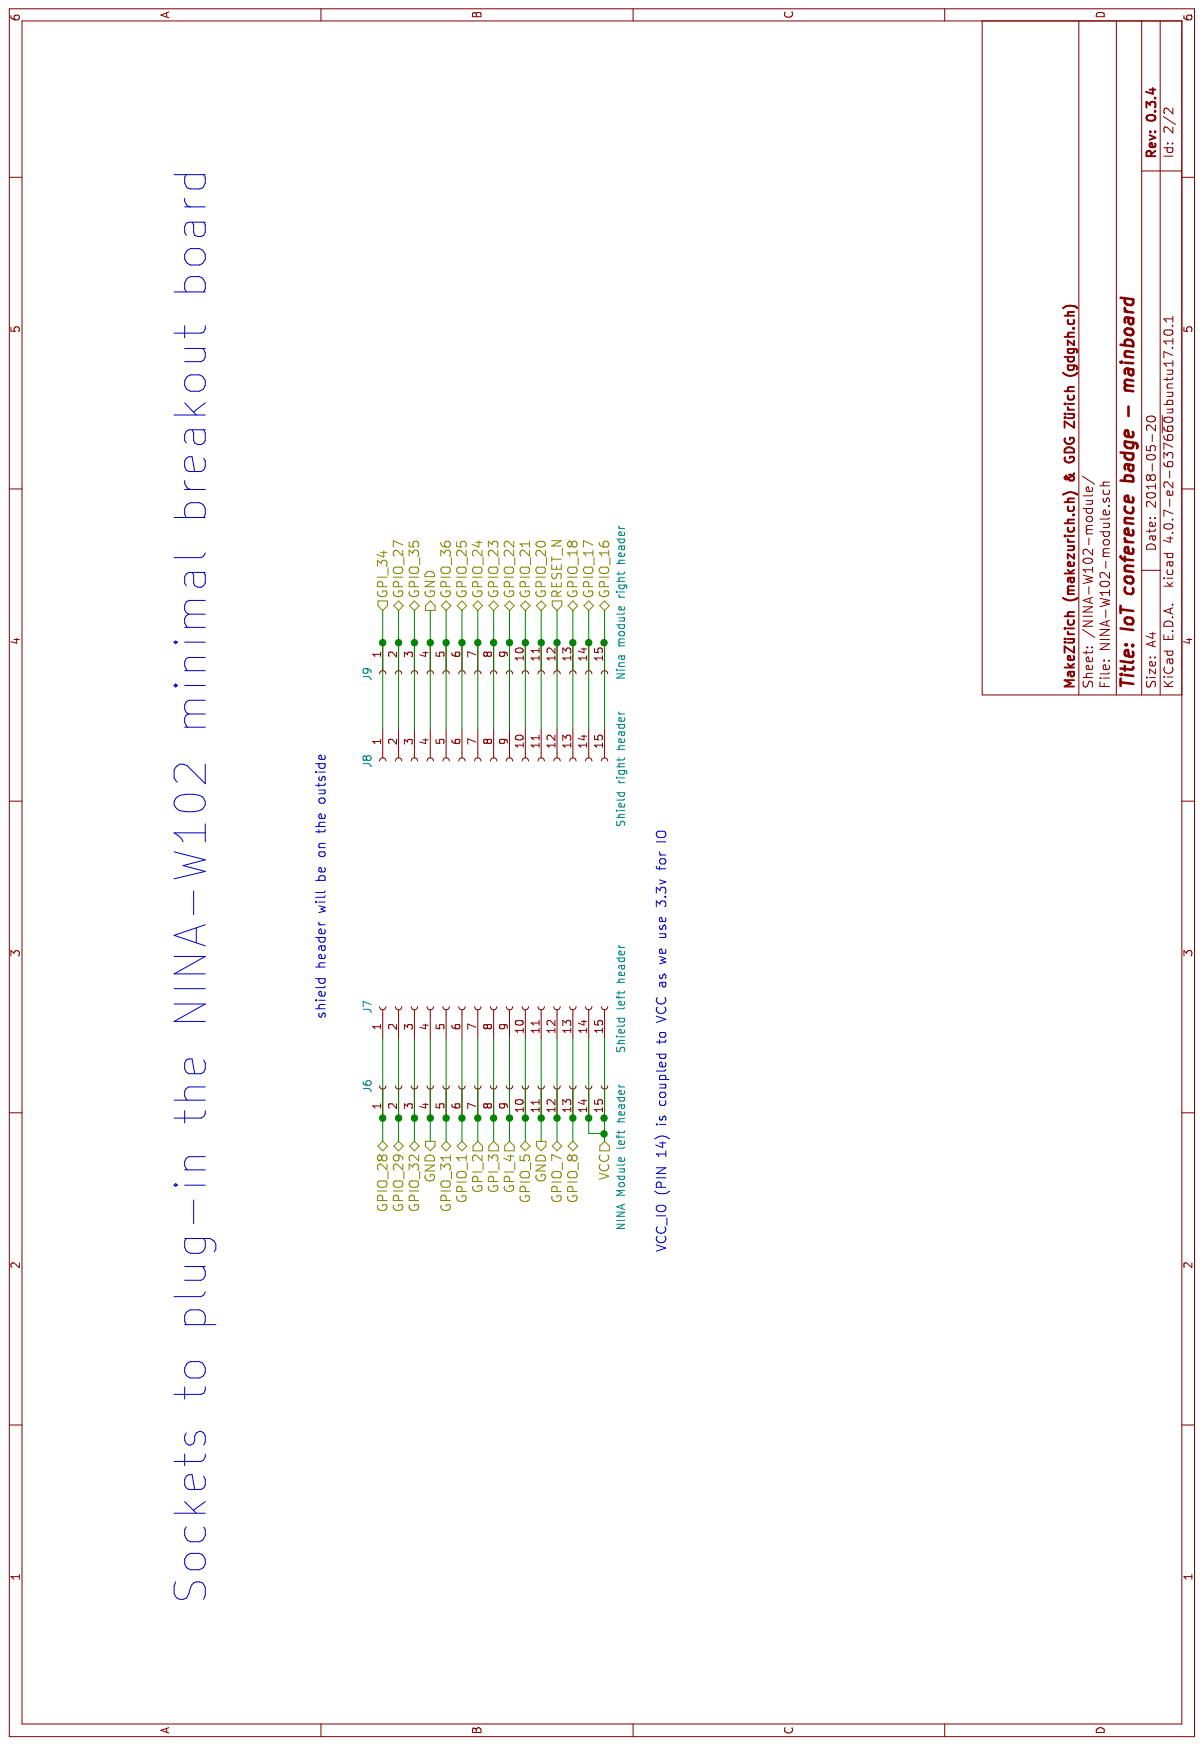
[picture p36: page 2]
