rac2030/IoT-conference-badge/hardware/badge-mainboard-rev.0.3.5.pdf

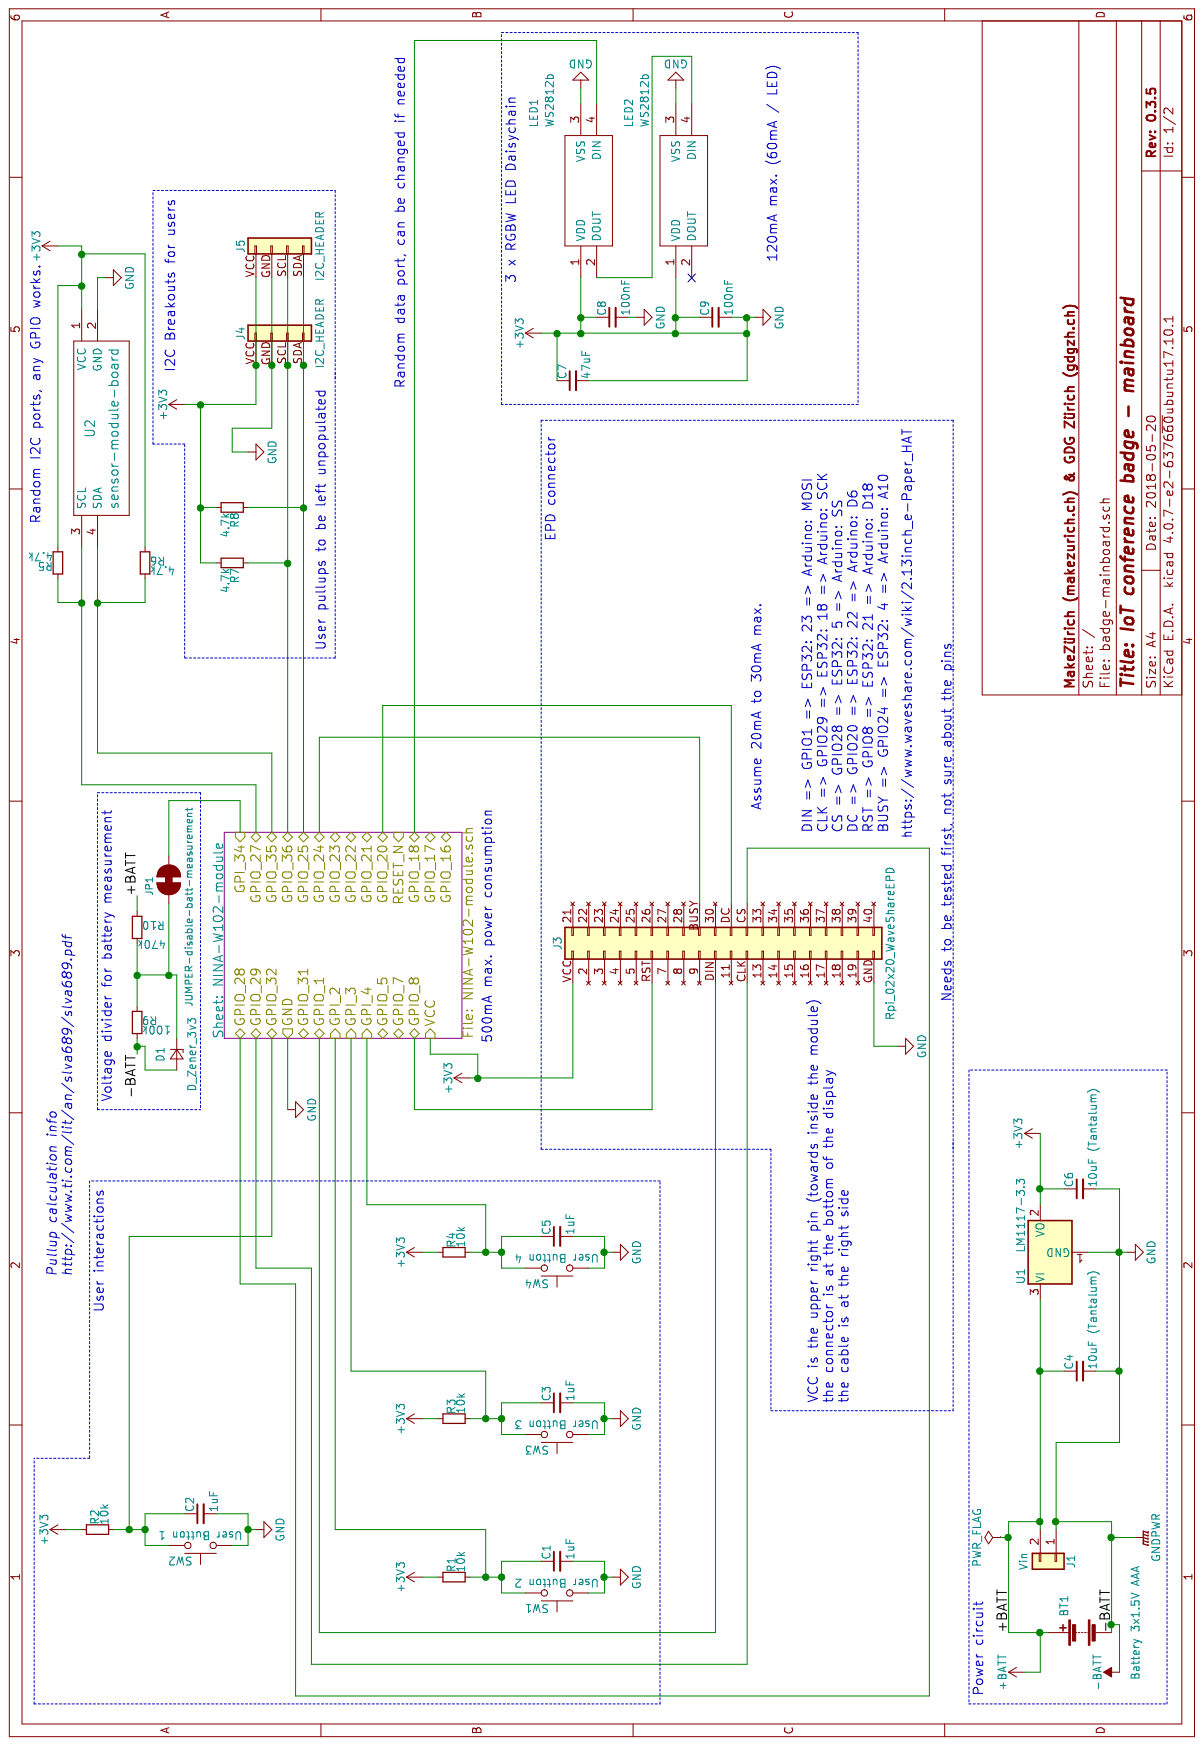
[picture p37: page 1]

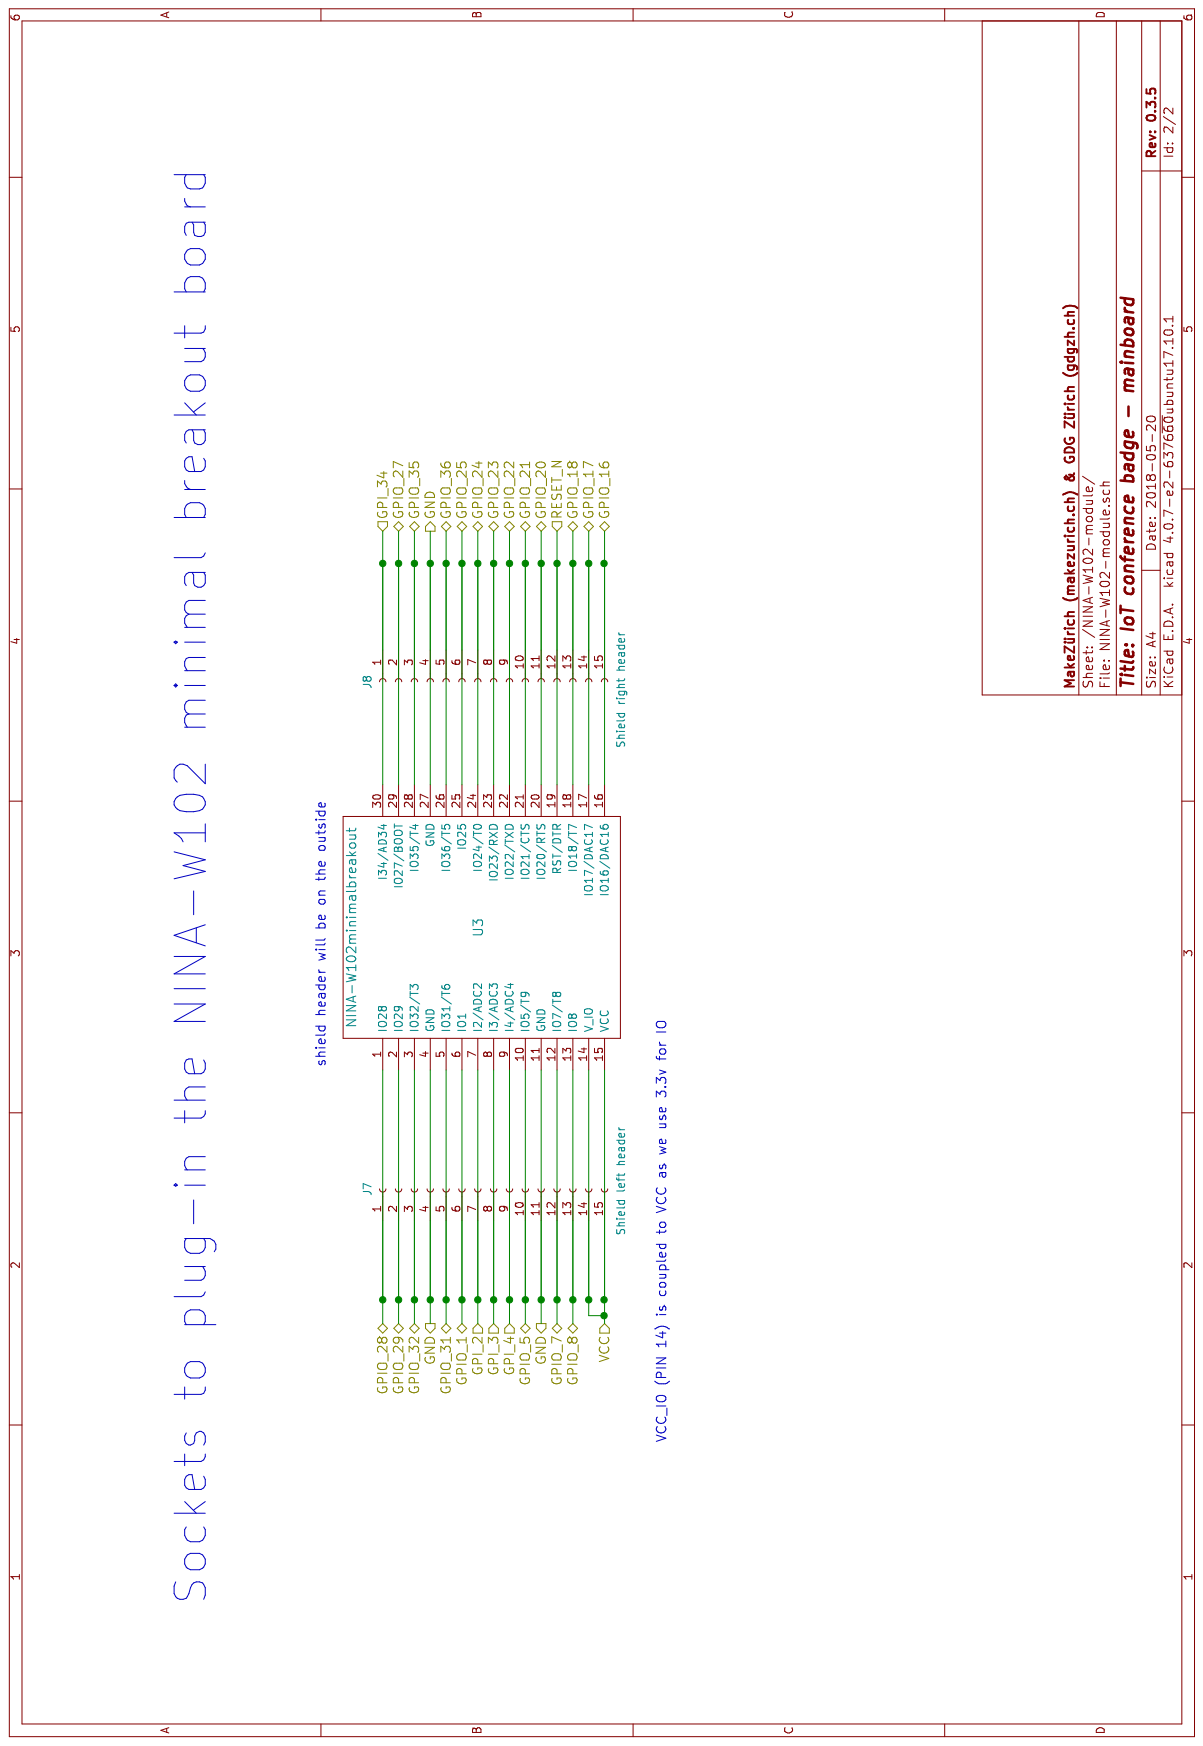
[picture p38: page 2]
