rac2030/IoT-conference-badge/hardware/badge-mainboard-rev.0.3.6.pdf

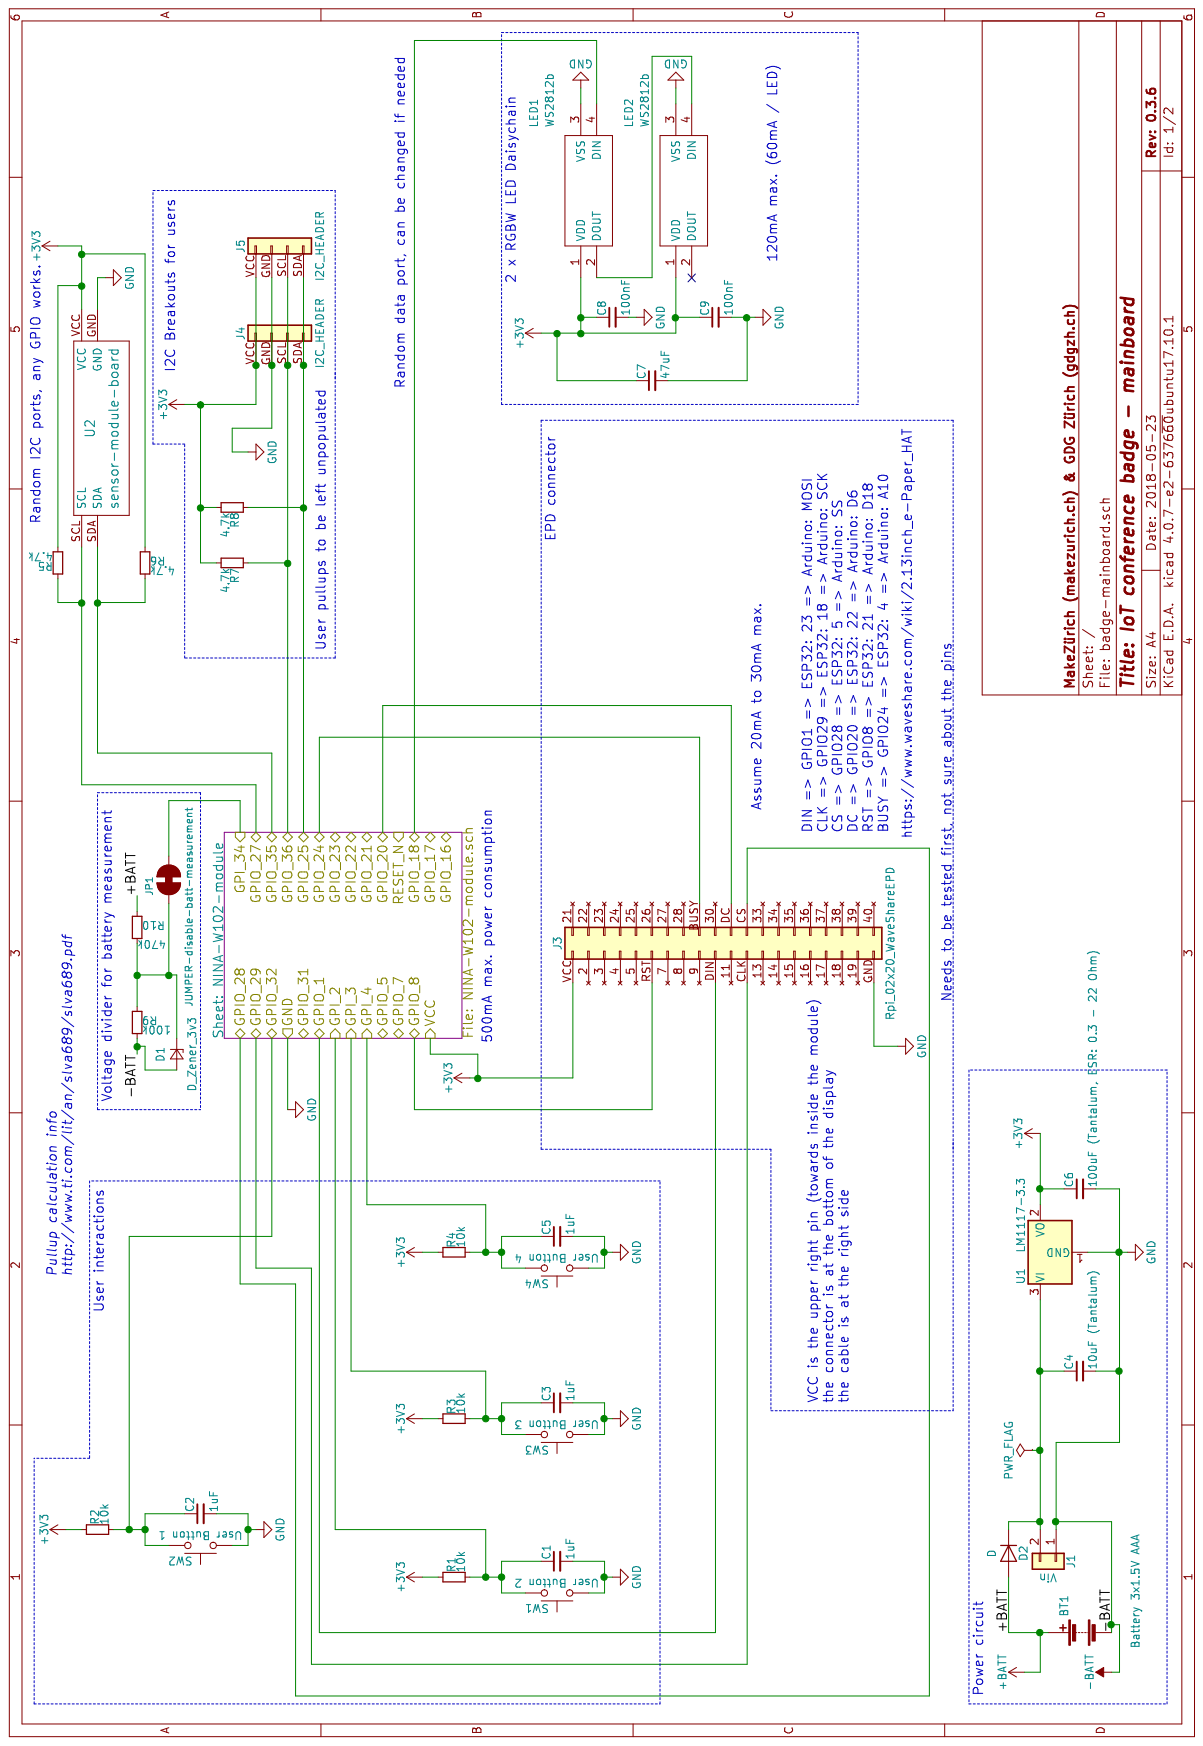
[picture p39: page 1]

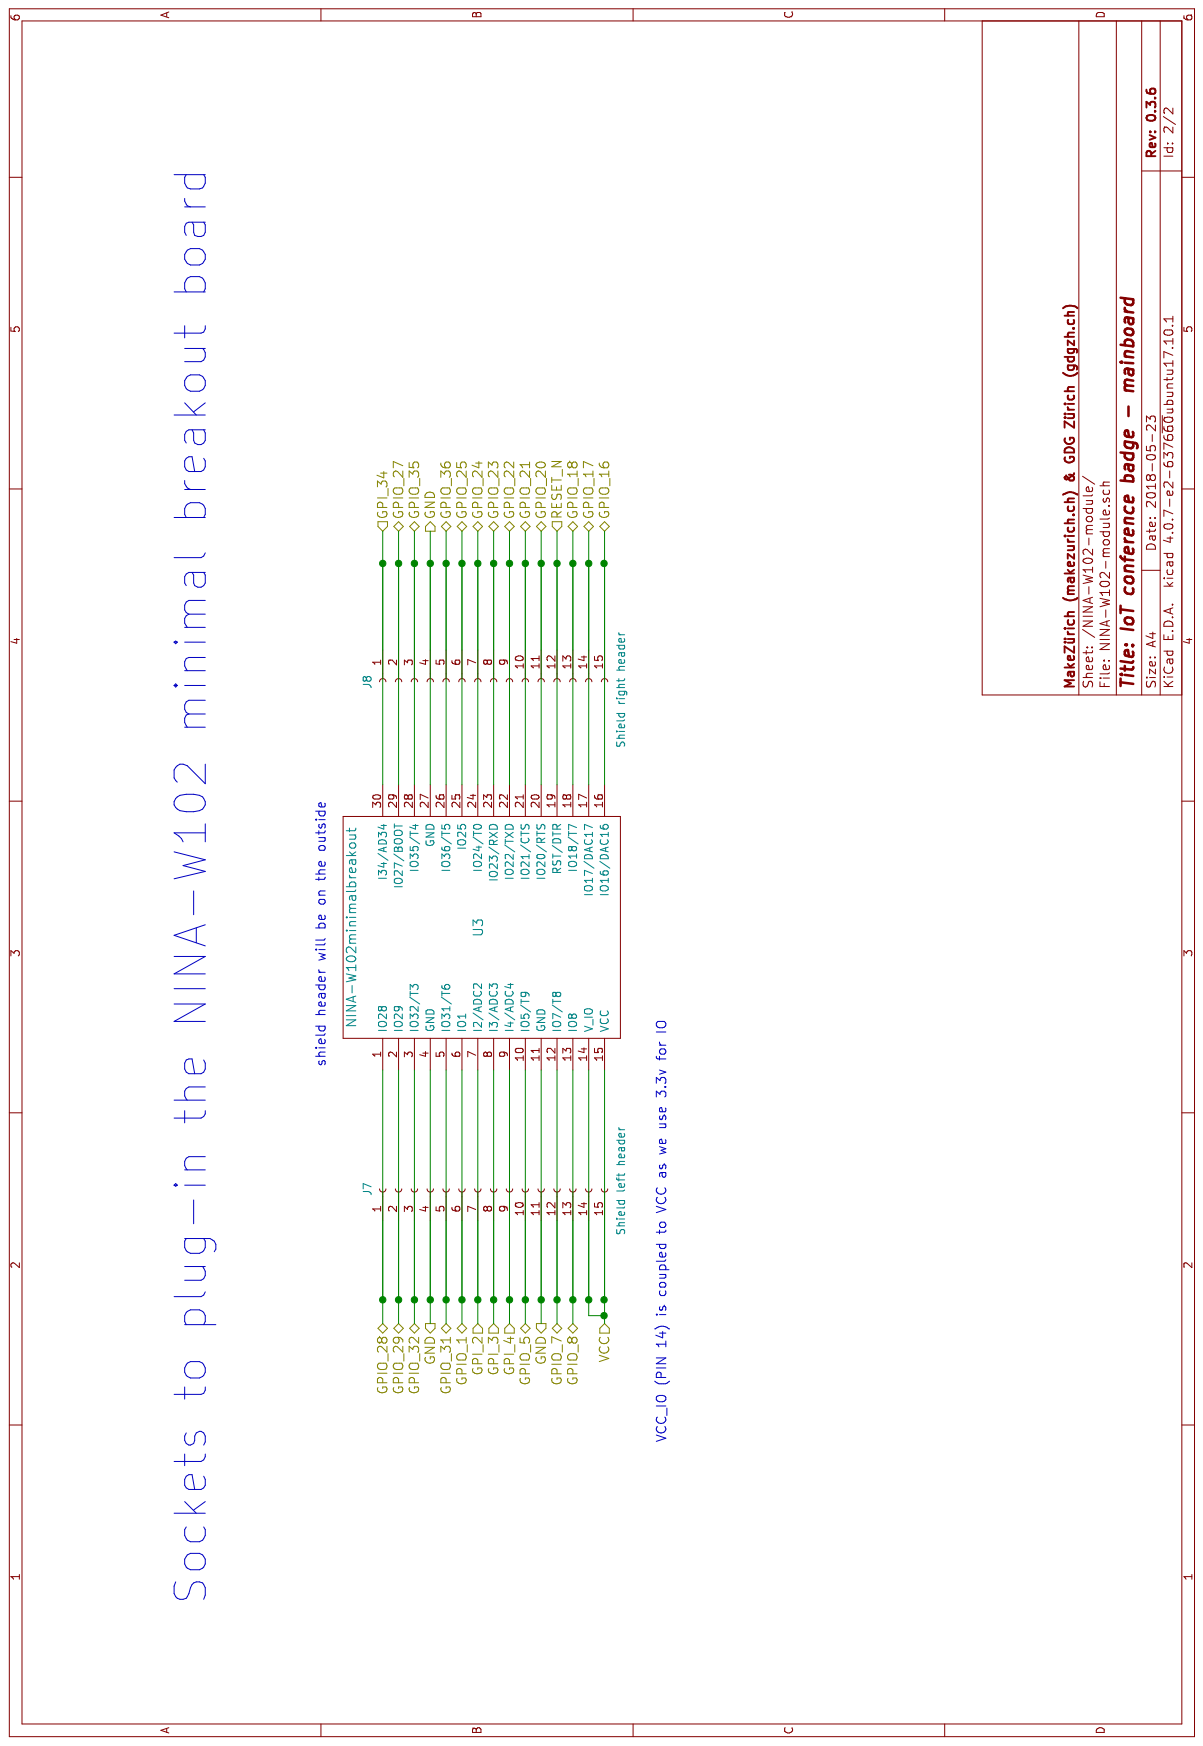
[picture p40: page 2]
