rac2030/IoT-conference-badge/hardware/_archive/MakeZürichBadge-legacydraft-rev0.2.pdf

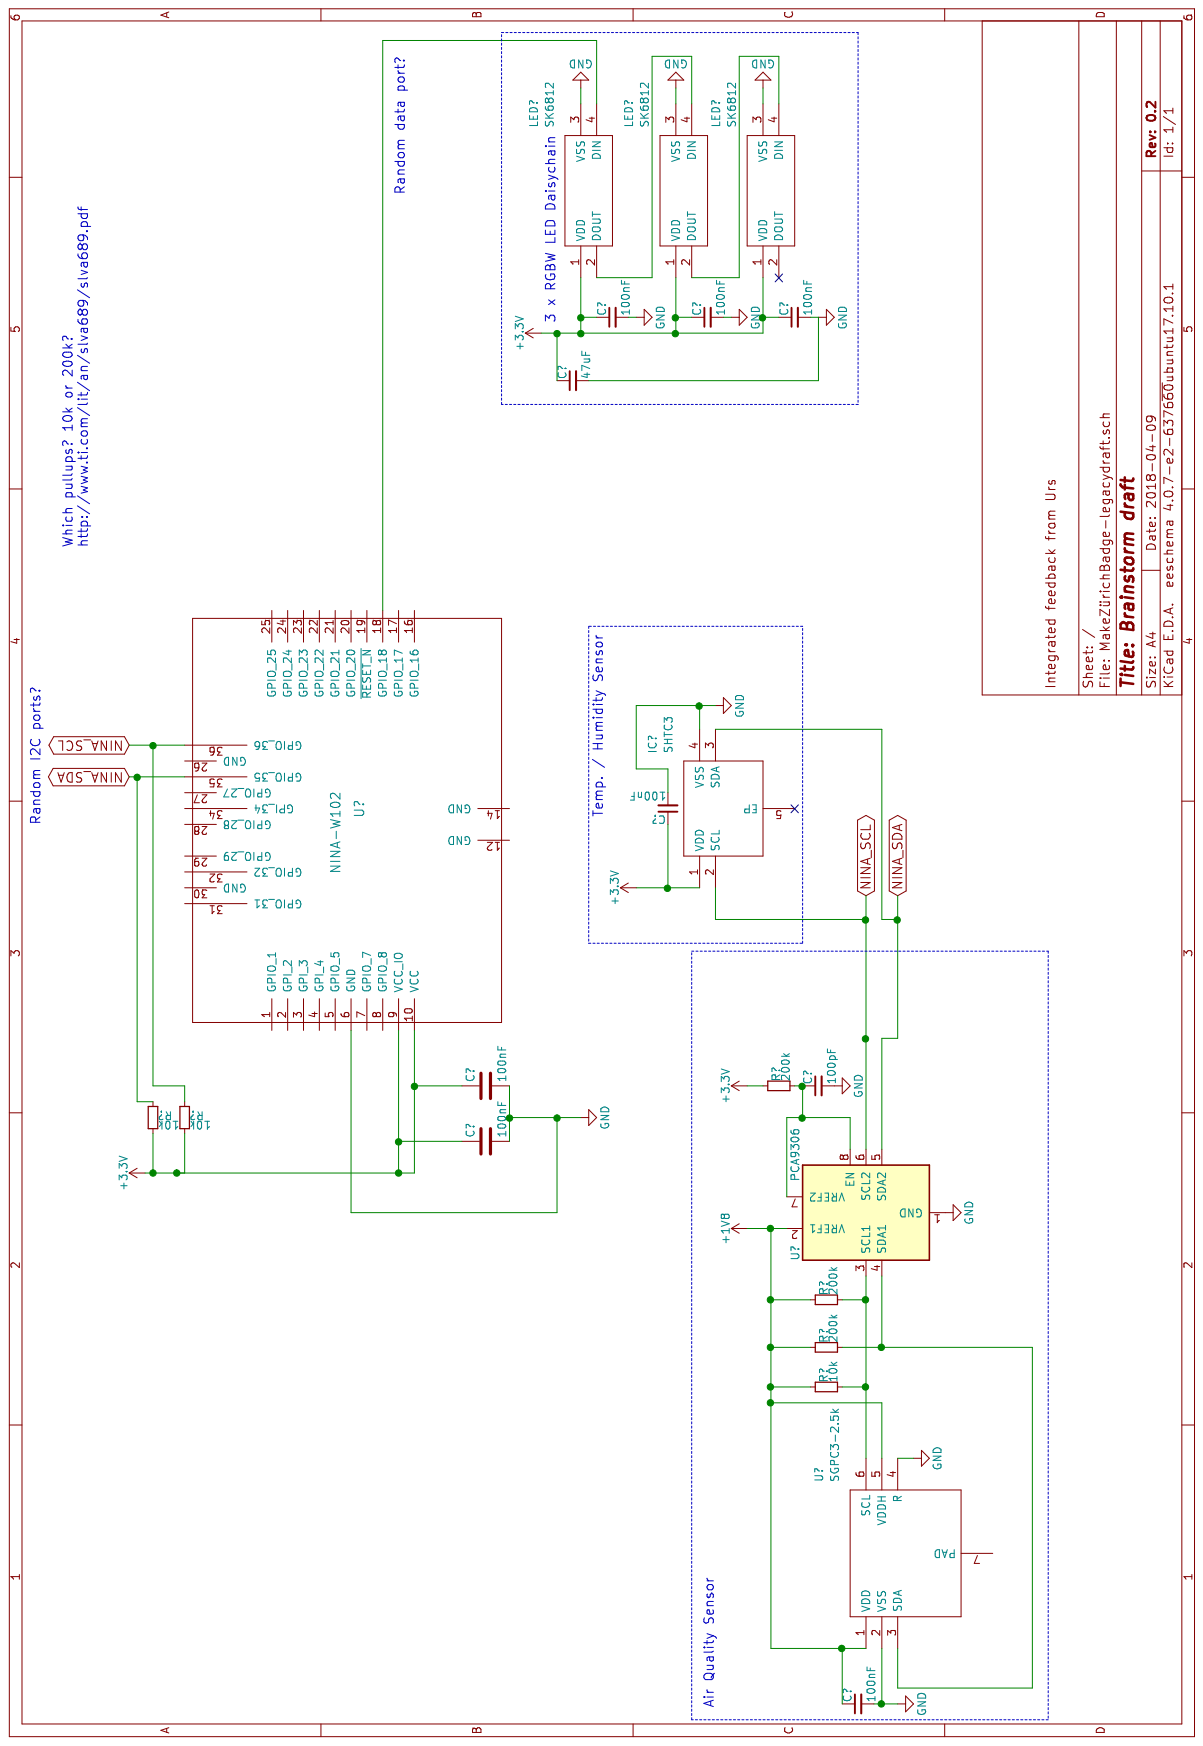
[picture p41: page 1]
