rac2030/IoT-conference-badge/firmware/examples/i2c_scanner/i2c_scanner.ino

 // --------------------------------------
// i2c_scanner
// Based on https://playground.arduino.cc/Main/I2cScanner
//   Corrected Serial speed to NINA's defaults
//
// This sketch tests the standard 7-bit addresses
// Devices with higher bit address might not be seen properly.
//

/**
 * !!!! A warning, you need to disconnect any I2C device on the user bus prior to programming 
 * as the pins have dual use and thats leading to a lockup and you get an error message 
 * during programming. !!!!
 * 
 * 
 * Example Output when a device is connected on the user I2C bus:
 *  I2C Scanner
 *  Scanning Internal I2C bus...
 *  >> I2C device found at address 0x58  !
 *  >> I2C device found at address 0x70  !
 *  done
 *  
 *  Scanning User I2C bus...
 *  >> I2C device found at address 0x3C  !
 *  done
 * 
 * Or if no user device is connected, the second part will look like:
 *  Scanning User I2C bus...
 *  >> No I2C devices found
 * 
 * The sensor module on the badge has 2 sensors from Sensirion, those are
 * - SHTC3 with address 0x70
 * - SGPC3 with address 0x58
 **/

#include <Wire.h>

// Define two wire objects (as we are going to use both available I2C buses at the same time)
TwoWire I2Cone = TwoWire(0);
TwoWire I2Ctwo = TwoWire(1);

// Internal I2C bus where the sensor module is connected to
#define SDA1 13  // GPIO35
#define SCL1 0   // GPIO27

// User I2C bus which is exposed in the 2 breakouts at the bottom of the badge
// Note that those have the pullups not populated, 
// depending on the module you connect you might need to populate them
#define SDA2 2   // GPIO25
#define SCL2 12  // GPIO36

void setup()
{
  I2Cone.begin(SDA1, SCL1);
  I2Ctwo.begin(SDA2, SCL2);
  Serial.begin(115200);
  delay(1000); // let serial console settle
  Serial.println("\nI2C Scanner");
}


void loop()
{
  scan("Internal I2C bus", I2Cone);
  scan("User I2C bus", I2Ctwo);
  delay(5000);           // wait 5 seconds for next scan
}

// We pass a description for displaying (friendly name) and the corresponding wire object as reference
void scan(String busDescription, TwoWire& wire)
{
  byte error, address;
  int nDevices;

  Serial.print("Scanning ");
  Serial.print(busDescription);
  Serial.println("...");

  nDevices = 0;
  for(address = 1; address < 127; address++ ) 
  {
    // The i2c_scanner uses the return value of
    // the Write.endTransmisstion to see if
    // a device did acknowledge to the address.
    wire.beginTransmission(address);
    error = wire.endTransmission();

    if (error == 0)
    {
      Serial.print(">> I2C device found at address 0x");
      if (address<16) 
        Serial.print("0");
      Serial.print(address,HEX);
      Serial.println("  !");

      nDevices++;
    }
    else if (error==4) 
    {
      Serial.print(">> Unknown error at address 0x");
      if (address<16) 
        Serial.print("0");
      Serial.println(address,HEX);
    }    
  }
  if (nDevices == 0)
    Serial.println(">> No I2C devices found\n");
  else
    Serial.println("done\n");
  delay(1000);
}
