rac2030/IoT-conference-badge/(commit log)

2018-04-08 Added kicad library as submodule
2018-04-08 Added 3rd party libraries from SamacSys
    [PCA9306TDCURQ1.stl, PCA9306TDCURQ1.stp, SGPC3-2.5k.stl, SGPC3-2.5k.stp, SHTC1.stl, SHTC1.stp, TPS767D318PWP.stl, TPS767D318PWP.stp]
2018-04-08 Added brainstorm draft document with revision changes from Urs
    [MakeZürichBadge-legacydraft.sch]
2018-04-08 Added empty schematics as starting point
    [badge-mainboard.kicad_pcb, badge-mainboard.sch]
2018-04-08 Added legacy printout for easy viewing without KiCad
2018-04-15 splitted parts into connected schematic sheets
    [EPD.sch, badge-mainboard.sch, power.sch, programmer.sch, sensors.sch]
2018-04-17 Added printout of rev.0.1.0
2018-04-29 Added NINA breakout module
    [EPD.sch, NINA-W102-module.sch, badge-mainboard.sch, power.sch, programmer.sch, sensors.sch]
2018-04-29 Added I2C headers and connected programmer to nina module
    [NINA-W102-module.sch, badge-mainboard.sch]
2018-04-30 Changed pullups for i2c to 4.7k
    [badge-mainboard.sch]
2018-04-30 removed leftover pullup
    [sensors.sch]
2018-04-30 removed comment and added new question
    [sensors.sch]
2018-04-30 Added 4 user buttons
    [EPD.sch, NINA-W102-module.sch, badge-mainboard.sch, power.sch, programmer.sch, sensors.sch]
2018-04-30 added missing sub schema file and comments
    [NINA-W102-module.sch, badge-mainboard.sch, userInteractions.sch]
2018-05-02 Added unpopulated user pullups for I2C user bus
    [badge-mainboard.sch]
2018-05-02 Added latest printout
    [power.sch]
2018-05-03 Added notes for reverse current protection
    [power.sch]
2018-05-03 Added footprints from SamacSys
    [CP2102N-A01-GQFN20.stl, CP2102N-A01-GQFN20.stp, LTC3101EUF#PBF.stl, LTC3101EUF#PBF.stp]
2018-05-03 added pcb outline from Gonzalo
2018-05-16 moved sensor to module board, removed programmer as external will be used
    [EDI2CAP.CFG, EPD.sch, NINA-W102-module.sch, TPS78918DBVT.stl, TPS78918DBVT.stp, badge-mainboard.sch, power.sch, programmer.sch]
2018-05-16 cleaned programmer on carrier board
    [NINA-W102-module.sch, badge-mainboard.sch]
2018-05-17 Added BOM printout and started PCB import
    [sensors-module-board.kicad_pcb, sensors-module-board.sch]
2018-05-17 started pcb layout
    [sensors-module-board.kicad_pcb]
2018-05-19 Added first PCB draft
    [sensors-module-board.kicad_pcb, sensors-module-board.sch]
2018-05-19 Added back silk
    [sensors-module-board.kicad_pcb]
2018-05-19 Added SPI connection for EPD
    [EPD.sch, badge-mainboard.sch, power.sch, userInteractions.sch]
2018-05-19 moved connections
    [badge-mainboard.sch]
2018-05-19 Moved connectors exactly to middle and added dimension drawing
    [sensors-module-board.kicad_pcb]
2018-05-19 added initial power circuit
    [EPD.sch, NINA-W102-module.sch, badge-mainboard.sch, userInteractions.sch]
2018-05-19 Finished first complete revision for badge carrier board schematic
    [NINA-W102-module.sch, _saved_EPD.sch, badge-mainboard.sch, userInteractions.sch]
2018-05-20 Removed diode as not needed there
    [NINA-W102-module.sch, badge-mainboard.sch]
2018-05-20 Added battery measurement trough ADC PIN and a voltage divider that is good up to 19V
    [badge-mainboard.kicad_pcb, badge-mainboard.sch]
2018-05-20 Added zener for GPIO protection
    [NINA-W102-module.sch, badge-mainboard.sch]
2018-05-20 Added some placement comments for the EPD to ensure orientation
    [badge-mainboard.sch]
2018-05-20 removed duplicated battery terminal
    [NINA-W102-module.sch, badge-mainboard.kicad_pcb, badge-mainboard.sch]
2018-05-20 Added nina breakout component for footprint matching
    [NINA-W102-module.sch]
2018-05-20 Added footprints for modules
    [NINA-W102-module.sch, badge-mainboard.sch, sensors-module-board.kicad_pcb]
2018-05-20 Initial netlist import and start of placing components
    [NINA-W102-module.sch, badge-mainboard.kicad_pcb, badge-mainboard.sch]
2018-05-21 Add diagonal white silkscreen
    [sensors-module-board.kicad_pcb]
2018-05-21 Add 3D models
    [BG045-10-X-0600-0300-X-X_revD.STEP, BG120-40-X-1-X-X_revD.STEP, BG130-05-X-0350-X-X_revE.STEP, BG180-10-X-0-X-X_revE.STEP]
2018-05-21 Fixed silkscreen orientation on back of PCB to match badge layout
    [sensors-module-board.kicad_pcb]
2018-05-23 Fix 3v3 to GND connection on `ws28b`
    [NINA-W102-module.sch, badge-mainboard.sch]
2018-05-23 Update netlist
    [badge-mainboard.kicad_pcb]
2018-05-23 Added diode and cleanedup shematic
    [NINA-W102-module.sch, badge-mainboard.sch]
2018-05-23 Added BOM and schematic printout of r.0.3.6
2018-05-23 Added comments for BOM
    [badge-mainboard.sch]
2018-05-23 added some more comments
    [NINA-W102-module.sch, badge-mainboard.kicad_pcb, badge-mainboard.sch]
2018-05-23 Basic component placing on PCB done
    [badge-mainboard.kicad_pcb]
2018-05-23 placement refined
    [badge-mainboard.kicad_pcb]
2018-05-23 Added traces to some components
    [badge-mainboard.kicad_pcb]
2018-05-24 Added some more traces
    [badge-mainboard.kicad_pcb]
2018-05-24 Added fill/keep out zones
    [badge-mainboard.kicad_pcb]
2018-05-24 Added more traces and GND vias
    [badge-mainboard.kicad_pcb]
2018-05-24 Added more tracks
    [badge-mainboard.kicad_pcb]
2018-05-24 Added last tracks
    [badge-mainboard.kicad_pcb]
2018-05-24 Added more GND plane vias
    [badge-mainboard.kicad_pcb]
2018-05-24 Added QR code for quest during hackathon
    [badge-mainboard.kicad_pcb]
2018-05-24 Added GDG logo
    [badge-mainboard.kicad_pcb]
2018-05-24 Added landing url for documentation
    [badge-mainboard.kicad_pcb]
2018-05-25 Fixed some silkscreen labeling placements
    [badge-mainboard.kicad_pcb]
2018-05-25 Add white diagonal band as silkscreen
    [badge-mainboard.kicad_pcb]
2018-05-25 Defining diode specifically as shotky
    [badge-mainboard.sch]
2018-05-26 Finished silkscreen design
    [badge-mainboard.kicad_pcb]
2018-05-26 Shorter visible URL
    [badge-mainboard.kicad_pcb]
2018-05-26 Backside pin labels
    [badge-mainboard.kicad_pcb]
2018-05-26 Add batt and J1 polarity labels
    [badge-mainboard.kicad_pcb]
2018-05-26 Fix track near pad
    [badge-mainboard.kicad_pcb]
2018-05-26 Remove via and track that are too close to pad
    [badge-mainboard.kicad_pcb]
2018-05-26 Switch polarity labels to front silkscreen
    [badge-mainboard.kicad_pcb]
2018-05-26 Added labels on the front and bumped version
    [badge-mainboard.kicad_pcb, badge-mainboard.sch]
2018-05-26 Added pinlabels on front and date on back
    [badge-mainboard.kicad_pcb]
2018-05-27 Final texts
    [badge-mainboard.kicad_pcb]
2018-05-27 Adding final gerbers ready to print
    [badge-mainboard.kicad_pcb]
2018-06-02 Fixed silkscreen and added more space to border for I2C breakout pads
    [sensors-module-board.kicad_pcb, sensors-module-board.sch]
2018-06-16 Added button with interrupt example
2018-06-16 Simple I2C bus scanner with port guessing, not yet working on the NINA
2018-06-16 scanner example that does not abort, seems to still not be able to list i2c devices correctly
    [I2CScannerWithPortGuess.ino]
2018-06-16 Add i2c scanner example
2018-06-16 Extended example to work with the 2 defined I2C buses on the badge
2018-06-16 Fixed a bug that showed colors onlyon first led
    [LED-Siren.ino]
2018-06-16 Added example code tu turn leds off, for resetting the state
    [LED-OFF.ino]
2018-06-16 Added modified gXPD simple example, not working yet
    [GxEPD_SPI_TestExample_NINA.ino]
